dkontiscom/cinetracker/hardware/carrier/fab/carrier-v0.61-1to1-fit-check.pdf

## CineTracker carrier v0.61 - 1:1 fit check (print at 100 %, no scaling)

Board outline, silkscreen, fab and courtyard layers. The 50 mm bar must measure 50.0 mm on paper.
Place the physical M8 sockets, BNC, Teensy 4.1 (USB to the left) and the 1x4 header on the outlines. Connector courtyards = body outlines from the vendor drawings.

50 mm

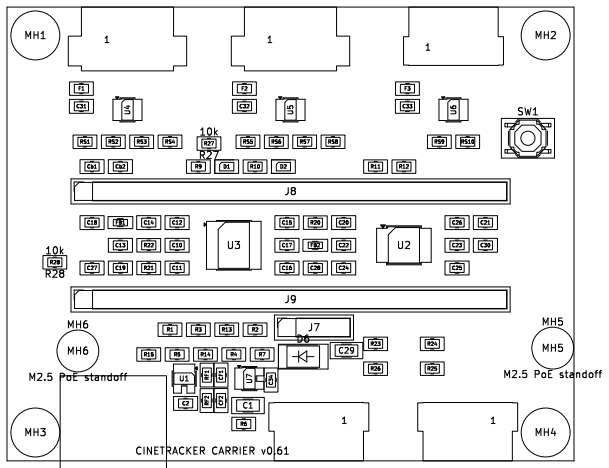
[picture p3: figure]
