dkontiscom/cinetracker/hardware/poe/fab/poe-v0.61-stack-1to1-fit-check.pdf

## CineTracker stack v0.61 / PoE v0.61 - 1:1 fit check (print at 100 %, no scaling)

Top view, carrier coordinates. Grey: carrier v0.61 (outline, silkscreen, courtyards). Red: PoE board v0.61 (outline, copper, silkscreen, courtyards). Panel edge at y = 64 for both boards. Connectors are drawn by their on-board courtyards. The 50 mm bar must measure 50.0 mm on paper.

50 mm

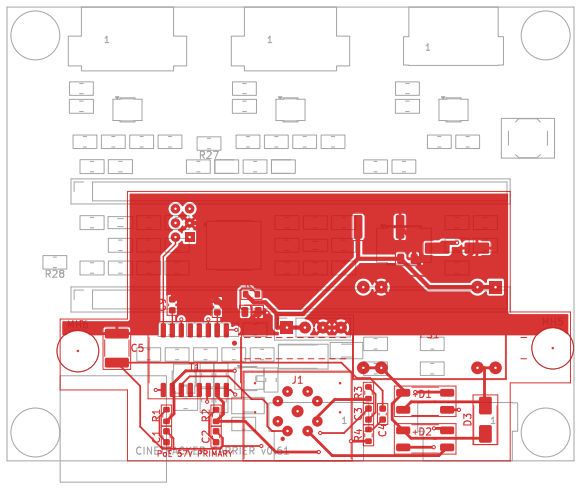
[picture p4: figure]
