dkontiscom/cinetracker/hardware/poe/documentation/poe-v0.61-bottom.png

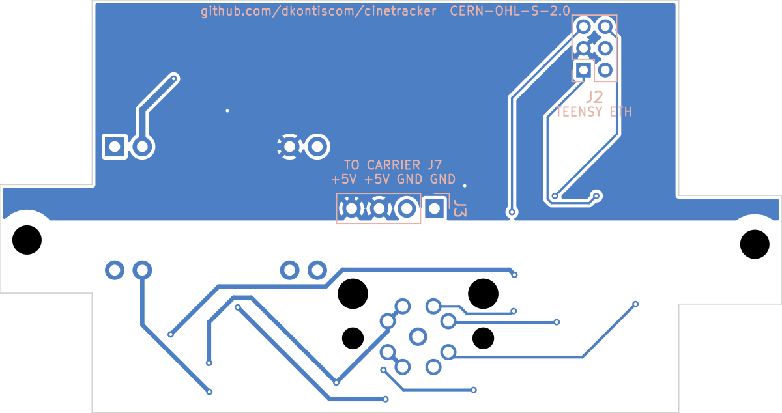
hardware/poe/documentation/poe-v0.61-bottom.png
