dkontiscom/cinetracker/hardware/poe/documentation/poe-v0.61-top.png

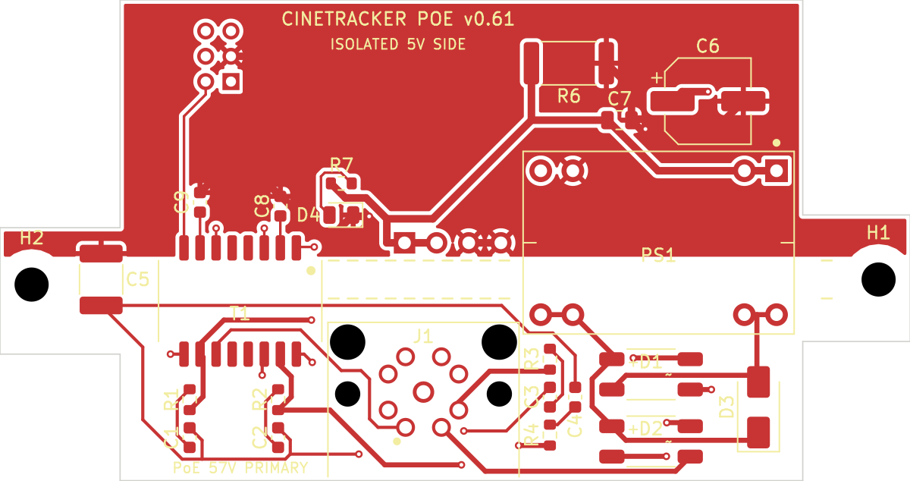
hardware/poe/documentation/poe-v0.61-top.png
