dkontiscom/cinetracker/hardware/carrier/fab/carrier-v0.61-BOM-full.csv

Qty/board | Designator | Description | Manufacturer | MPN | LCSC | JLC library | Process | JLC stock (2026-10-11) | Bought for 5 boards (incl. attrition) | Unit USD | Line USD
2 | C1,C29 | 47uF 10V X5R 1206 | Samsung | CL31A476MPHNNNE | C96123 | Basic | SMT | 390122 | 14 | 0.2593 | 3.63
12 | C2,C12,C14,C15,C17,C20,C22,C24,C31,C32,C33,C34 | 100nF 50V X7R 0805 | YAGEO | CC0805KRX7R9BB104 | C49678 | Basic | SMT | 19827943 | 70 | 0.0189 | 1.32
2 | C10,C11 | 2.2uF 25V X7R 0805 | Samsung | CL21B225KAFNNNE | C19110 | Extended | SMT | 94974 | 20 | 0.0328 | 0.66
9 | C13,C16,C21,C23,C25,C27,C28,Cb1,Cb2 | 10uF 25V X5R 0805 | Samsung | CL21A106KAYNNNE | C15850 | Basic | SMT | 4331515 | 55 | 0.0688 | 3.78
2 | C18,C19 | 2.2nF 50V C0G 0805 | Samsung | CL21C222JBFNNNE | C28260 | Basic | SMT | 98301 | 14 | 0.0202 | 0.28
2 | C26,C30 | 1uF 50V X7R 0805 | Samsung | CL21B105KBFNNNE | C28323 | Basic | SMT | 1825289 | 20 | 0.04 | 0.8
2 | CF1,CF2 | 68pF 50V NP0/C0G ±1% 0805 | YAGEO | CC0805FRNPO9BN680 | C541517 | Extended | SMT | 6909 | 18 | 0.0334 | 0.6
1 | D1 | LED yellow-green 0805 | Hubei KENTO | KT-0805YG | C2292 | Extended | SMT | 13261 | 15 | 0.0161 | 0.24
1 | D2 | LED yellow 0805 | Hubei KENTO | KT-0805Y | C2296 | Basic | SMT | 322508 | 15 | 0.0153 | 0.23
3 | D3,D4,D5 | bidir ESD +/-9V X1SON-2 (DPY) | Texas Instruments | TPD1E10B09DPYR | C88031 | Extended | SMT | 120763 | 19 | 0.0891 | 1.69
1 | D6 | TVS 5V uni 400W SMA | Littelfuse | SMAJ5.0A | C83329 | Extended | SMT | 29987 | 7 | 0.1237 | 0.87
3 | F1,F2,F3 | PTC 0.1A hold 0.3A trip 0805 | Bourns | MF-PSMF010X-2 | C116171 | Extended | SMT | 52217 | 23 | 0.0514 | 1.18
2 | FB1,FB2 | 600R@100MHz 500mA 0805 | Sunlord | GZ2012D601TF | C1017 | Basic | SMT | 311642 | 20 | 0.0201 | 0.4
1 | J1 | BNC 75ohm RA bulkhead THT | Kinghelm | KH-BNC75-3511 | C2837588 | Extended | THT | 734 | 5 | 0.9496 | 4.75
1 | J2 | M8 4P A female RA THT | CAZN | M8-S4A-GPL M10-JD | C19108970 | Extended | THT | 264 | 5 | 5.0197 | 25.1
2 | J3,J4 | M8 6P A female RA THT | dosinconn | DS869FPR0470-6P | C42395389 | Extended | THT | 53 | 10 | 3.8584 | 38.58
2 | J5,J6 | M8 3P female RA THT | CAZN | M8-S3A-GPLM10 | C42931206 | Extended | THT | 265 | 10 | 4.1157 | 41.16
1 | J7 | 1x4 female 2.54mm 8.5mm THT (5V in) | XKB Connection | X6511FV-04-C85D32 | C718241 | Extended | THT | 5001 | 6 | 0.2053 | 1.23
2 | J8,J9 | 1x24 female 2.54mm 8.5mm THT | XKB Connection | X6511FV-24-C85D32 | C2883741 | Extended | THT | 978 | 10 | 0.645 | 6.45
3 | R1,R2,R4 | 2k 0.1% 50ppm thin film 0805 | YAGEO | RT0805BRE072KL | C706274 | Extended | SMT | 116950 | 19 | 0.0546 | 1.04
1 | R3 | 1k 0.1% 25ppm thin film 0805 | YAGEO | RT0805BRD071KL | C110774 | Extended | SMT | 295592 | 13 | 0.0429 | 0.56
1 | R5 | 5.1k 0.1% 25ppm thin film 0805 | YAGEO | RT0805BRD075K1L | C122968 | Extended | SMT | 95105 | 9 | 0.059 | 0.53
1 | R6 | 75R 1% 0805 | YAGEO | RC0805FR-0775RL | C141697 | Extended | SMT | 145170 | 15 | 0.0076 | 0.11
5 | R7,R20,R25,R27,R28 | 10k 1% 0805 | UNI-ROYAL | 0805W8F1002T5E | C17414 | Basic | SMT | 58488066 | 35 | 0.0033 | 0.12
4 | R9,R10,R21,R22 | 470R 1% 0805 | UNI-ROYAL | 0805W8F4700T5E | C17710 | Basic | SMT | 2704814 | 30 | 0.0048 | 0.14
2 | R11,R12 | 2k 1% 0805 | UNI-ROYAL | 0805W8F2001T5E | C17604 | Basic | SMT | 5272441 | 20 | 0.0039 | 0.08
1 | R13 | 11R 1% 0805 | UNI-ROYAL | 0805W8F110JT5E | C17430 | Extended | SMT | 19227 | 15 | 0.0042 | 0.06
1 | R14 | 22R 1% 0805 | UNI-ROYAL | 0805W8F220JT5E | C17561 | Basic | SMT | 1632160 | 15 | 0.0045 | 0.07
1 | R15 | 5.6k 0.1% 25ppm thin film 0805 | PANASONIC | ERA6AEB562V | C445654 | Extended | SMT | 8029 | 9 | 0.0896 | 0.81
1 | R23 | 4.7k 1% 0805 | UNI-ROYAL | 0805W8F4701T5E | C17673 | Basic | SMT | 4702678 | 11 | 0.005 | 0.06
1 | R24 | 20k 1% 0805 | UNI-ROYAL | 0805W8F2002T5E | C4328 | Basic | SMT | 2350704 | 15 | 0.0042 | 0.06
1 | R26 | 1k 1% 0805 | UNI-ROYAL | 0805W8F1001T5E | C17513 | Basic | SMT | 45444566 | 15 | 0.0035 | 0.05
2 | RF1,RF2 | 150R 1% 0805 | UNI-ROYAL | 0805W8F1500T5E | C17471 | Basic | SMT | 439192 | 20 | 0.0056 | 0.11
10 | RS1,RS2,RS3,RS4,RS5,RS6,RS7,RS8,RS9,RS10 | 33R 1% 0805 | UNI-ROYAL | 0805W8F330JT5E | C17634 | Basic | SMT | 1515902 | 60 | 0.0047 | 0.28
1 | SW1 | Tact switch 5.1x5.1 SMD | XKB Connection | TS-1187A-B-A-B | C318884 | Basic | SMT | 382383 | 10 | 0.0206 | 0.21
2 | U1,U7 | 200MHz 360V/us op-amp SOT-23-5 | Texas Instruments | OPA356AIDBVR | C183100 | Extended | SMT | 947 | 10 | 1.0294 | 10.29
1 | U2 | Audio ADC 24-bit I2S TSSOP-14 | Texas Instruments | PCM1808PWR | C55513 | Extended | SMT | 15552 | 5 | 0.702 | 3.51
1 | U3 | Audio DAC 32-bit I2S TSSOP-20 | Texas Instruments | PCM5102APWR | C107671 | Extended | SMT | 7737 | 5 | 1.4463 | 7.23
3 | U4,U5,U6 | 4-ch ESD 5.5V SOT-23-6 | Texas Instruments | TPD4E1U06DBVR | C124691 | Extended | SMT | 23206 | 15 | 0.3649 | 5.47
