dkontiscom/cinetracker/hardware/poe/fab/poe-v0.61-BOM-full.csv

Qty/board | Designator | Description | Manufacturer | MPN | LCSC | JLC library | Process | JLC stock (2026-10-11) | Bought for 5 boards (incl. attrition) | Unit USD | Line USD
4 | C1,C2,C3,C4 | 10 nF 100 V X7R 0603 | YAGEO | CC0603KRX7R0BB103 | C107059 | Extended | SMT | 1242847 | 32 | 0.0089 | 0.28
1 | C5 | 1 nF 2 kV X7R 1812 | YAGEO | CC1812KKX7RDBB102 | C118019 | Extended | SMT | 12367 | 5 | 0.3953 | 1.98
1 | C6 | 100 uF 25 V aluminium electrolytic, 6.3 x 5.4 | KNSCHA | RST100UF25V004 | C4747964 | Extended | SMT | 263590 | 6 | 0.0413 | 0.25
1 | C7 | 10 uF 25 V X5R 0805 | Samsung | CL21A106KAYNNNE | C15850 | Basic | SMT | 4331725 | 15 | 0.0688 | 1.03
2 | C8,C9 | 100 nF 50 V X7R 0603 | YAGEO | CC0603KRX7R9BB104 | C14663 | Basic | SMT | 56599620 | 20 | 0.014 | 0.28
2 | D1,D2 | Bridge rectifier 600 V 1 A, MBS | MDD | MB6S | C2487 | Extended | SMT | 237940 | 15 | 0.0276 | 0.41
1 | D3 | TVS 58 V unidirectional, SMA | GOODWORK | SMAJ58A | C2980408 | Extended | SMT | 40883 | 13 | 0.0326 | 0.42
1 | D4 | LED green 0805 | Hubei KENTO | KT-0805G | C2297 | Basic | SMT | 2908107 | 15 | 0.0163 | 0.24
1 | J1 | M12 X-coded 8-pin female, right angle, PCB, 60 V, IEC 61076-2-109 | CAZN | M12-S8X-GPLM12-BJD | C7423431 | Extended | THT | 48 | 5 | 10.0653 | 50.33
1 | PS1 | 802.3af PD module, isolated 5 V 1.4 A (7 W at 70 C) | SDAPO | DP9900LP-5V | C5380108 | Extended | THT | 468 | 5 | 6.2624 | 31.31
4 | R1,R2,R3,R4 | 75 ohm 1% 0603 | UNI-ROYAL | 0603WAF750JT5E | C4275 | Basic | SMT | 1634250 | 30 | 0.0033 | 0.1
1 | R7 | 2.2 kohm 1% 0603 | UNI-ROYAL | 0603WAF2201T5E | C4190 | Basic | SMT | 7231901 | 15 | 0.0018 | 0.03
1 | T1 | 10/100 PoE+ LAN transformer with CMC, 720 mA, 1500 Vrms | CND-tek | B1608S | C507596 | Extended | SMT | 13658 | 5 | 0.302 | 1.51
1 | R6 | DNP |  |  |  |  | DNP (bleeder option)
1 | J3 | 5V to carrier J7 |  |  |  |  | long-pin header, fitted by hand (see design notes)
1 | J2 | 2x3 female header 2.0 mm, 4.3 mm, through hole (hand-solder, bottom side) | HanElectricity | 2005FV-2x3P | C18723065 |  | hand-soldered on the bottom side
