dkontiscom/cinetracker/hardware/carrier/documentation/cinetracker-carrier-v0.61-schematic.pdf

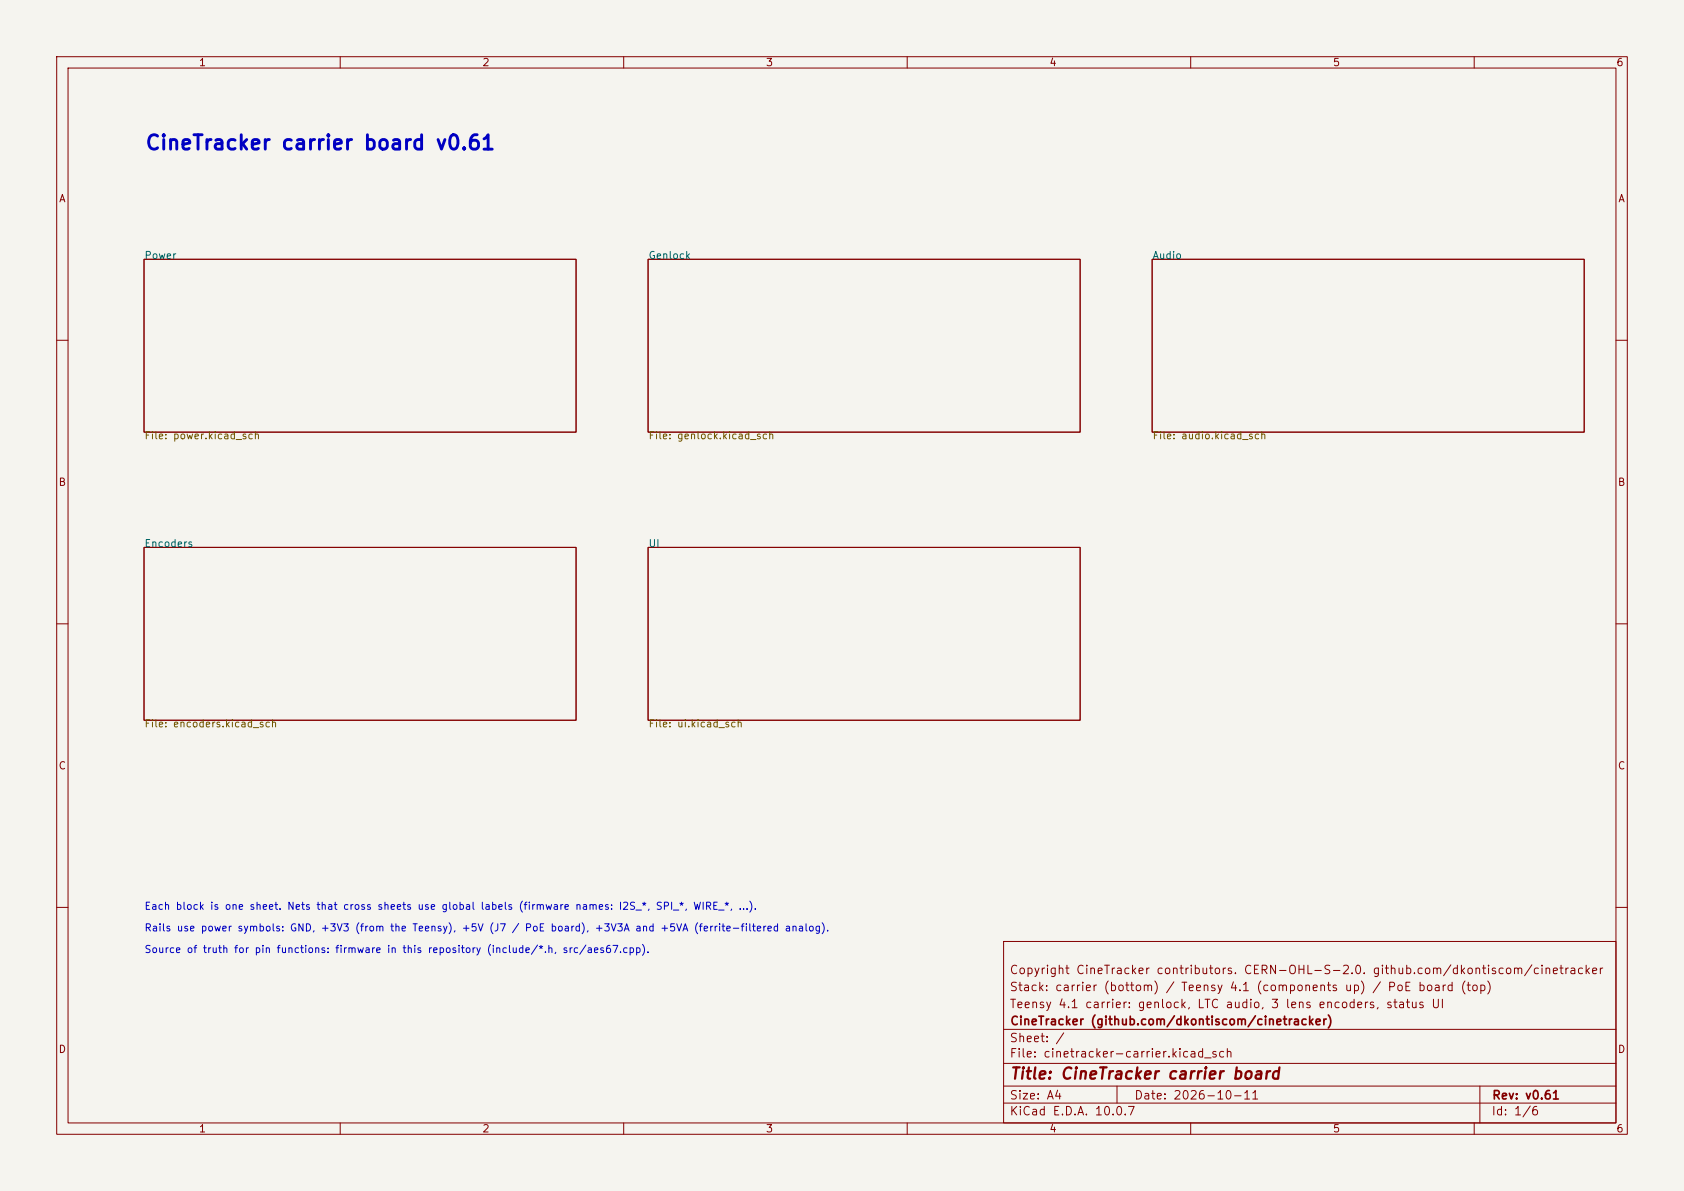
[picture p7: page 1]

Copyright CineTracker contributors. CERN-OHL-S-2.0. github.com/dkontiscom/cinetracker Encoders File: encoders.kicad_sch Power File: power.kicad_sch

File: audio.kicad_sch Genlock File: genlock.kicad_sch UI File: ui.kicad_sch

Each block is one sheet. Nets that cross sheets use global labels (firmware names: I2S_*, SPI_*, WIRE_*, ...). Rails use power symbols: GND, +3V3 (from the Teensy), +5V (J7 / PoE board), +3V3A and +5VA (ferrite-filtered analog). Source of truth for pin functions: firmware in this repository (include/*.h, src/aes67.cpp).

Stack: carrier (bottom) / Teensy 4.1 (components up) / PoE board (top)
Teensy 4.1 carrier: genlock, LTC audio, 3 lens encoders, status UI
CineTracker (github.com/dkontiscom/cinetracker)
Sheet: /
File: cinetracker-carrier.kicad_sch
Title: CineTracker carrier board

Size: A4 | Rev: v0.61
KiCad E.D.A. 10.0.7 | Id: 1/6

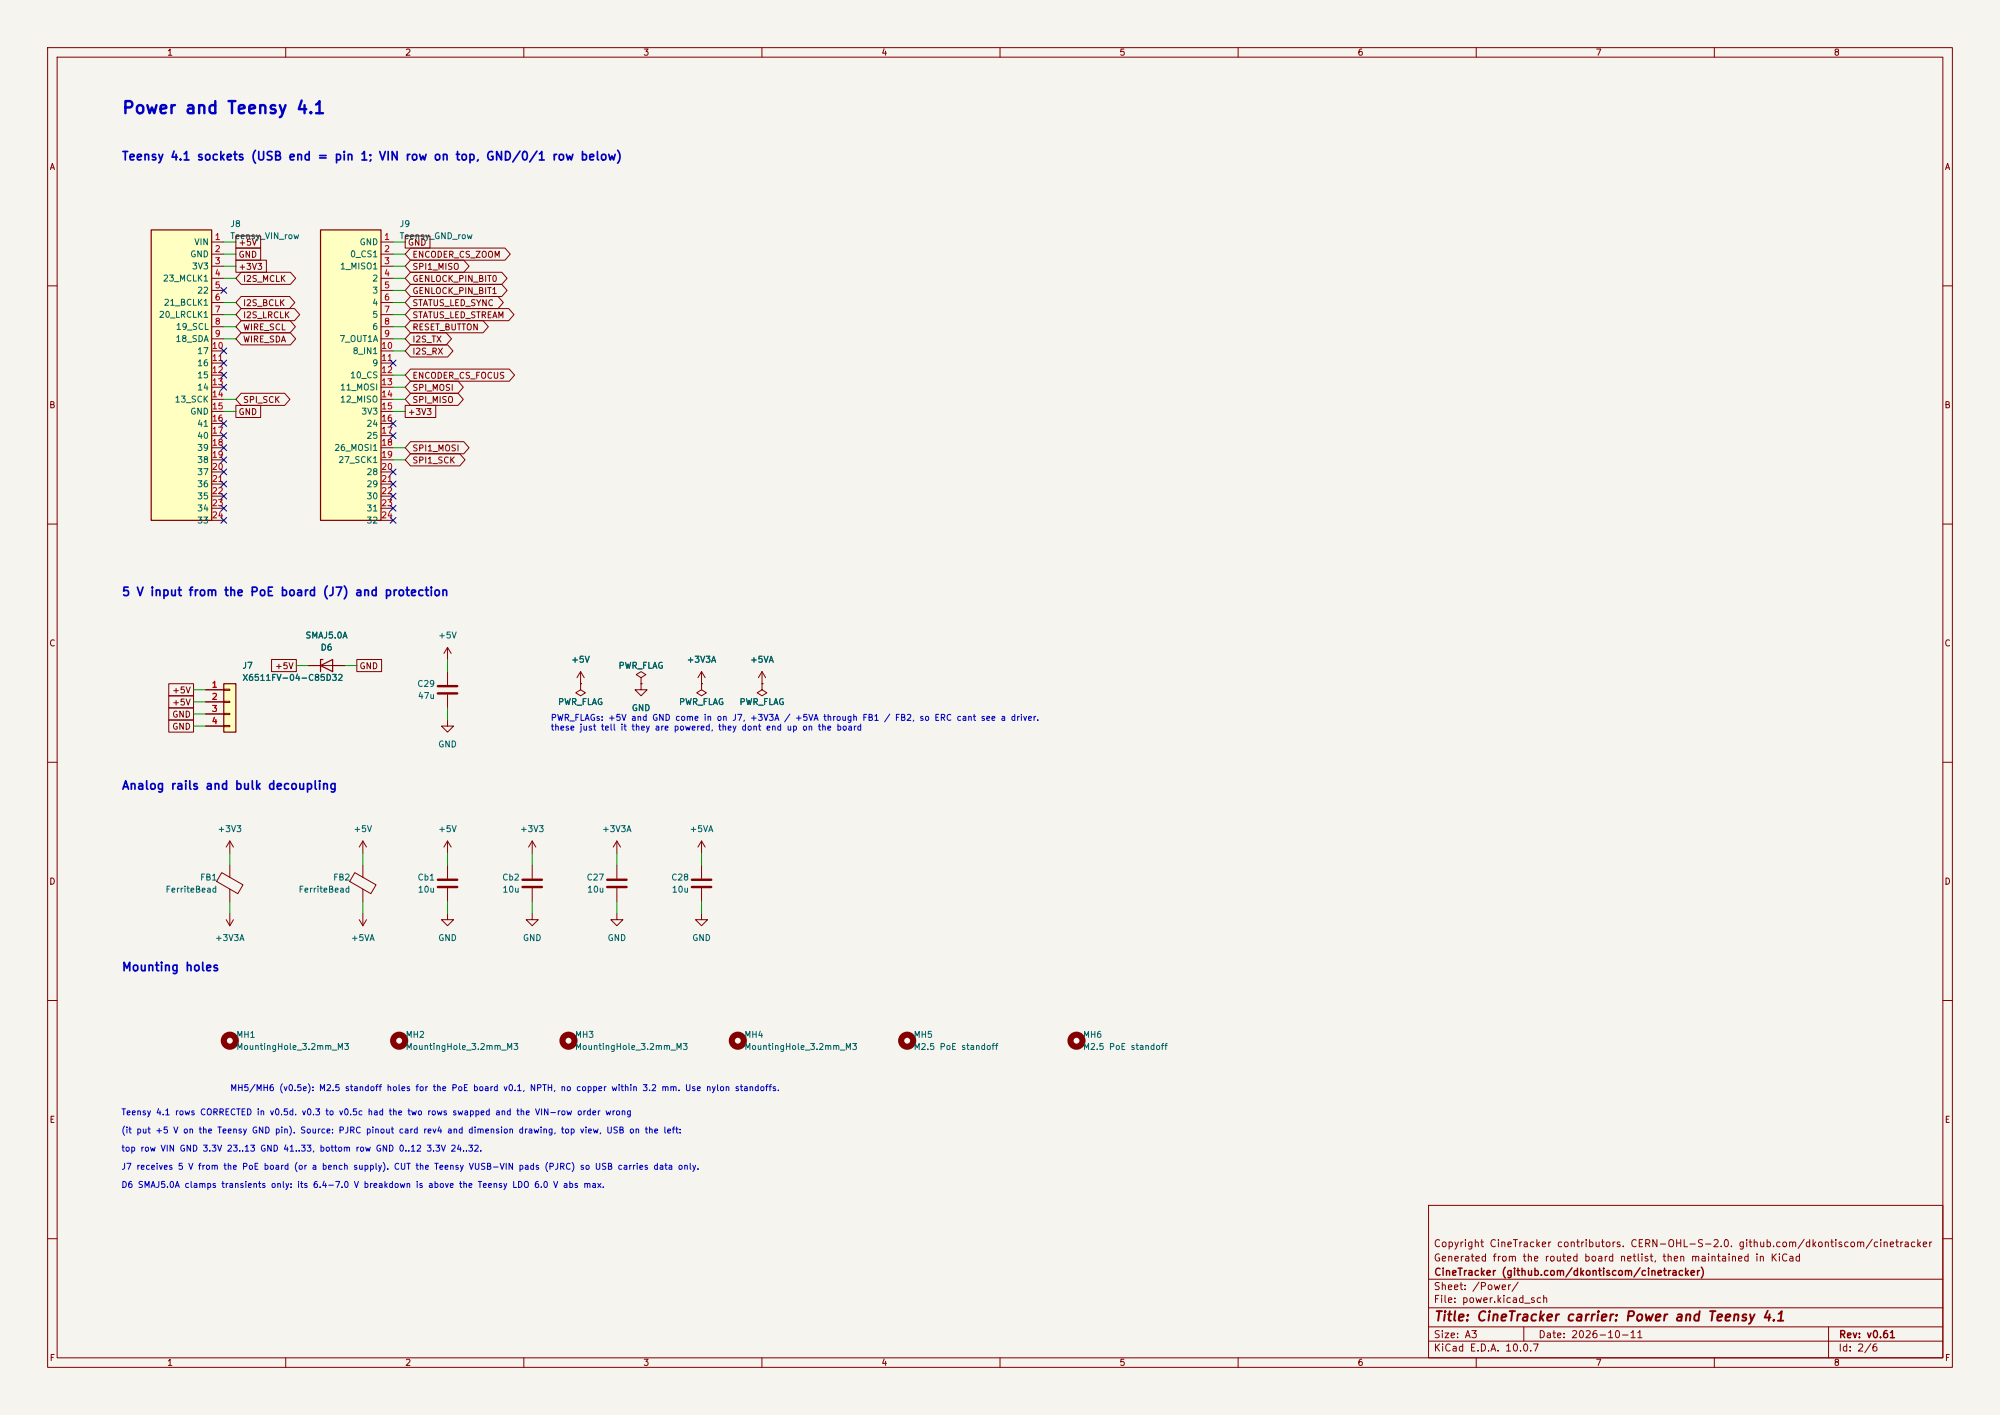
[picture p8: page 2]

SPI_MOSI Teensy 4.1 sockets (USB end = pin 1; VIN row on top, GND/0/1 row below)

5 V input from the PoE board (J7) and protection

PWR_FLAGs: +5V and GND come in on J7, +3V3A / +5VA through FB1 / FB2, so ERC cant see a driver. these just tell it they are powered, they dont end up on the board Analog rails and bulk decoupling

MH5/MH6 (v0.5e): M2.5 standoff holes for the PoE board v0.1, NPTH, no copper within 3.2 mm. Use nylon standoffs. Teensy 4.1 rows CORRECTED in v0.5d. v0.3 to v0.5c had the two rows swapped and the VIN-row order wrong

(it put +5 V on the Teensy GND pin). Source: PJRC pinout card rev4 and dimension drawing, top view, USB on the left: J7 receives 5 V from the PoE board (or a bench supply). CUT the Teensy VUSB-VIN pads (PJRC) so USB carries data only.

top row VIN GND 3.3V 23..13 GND 41..33, bottom row GND 0..12 3.3V 24..32. D6 SMAJ5.0A clamps transients only: its 6.4-7.0 V breakdown is above the Teensy LDO 6.0 V abs max.

Copyright CineTracker contributors. CERN-OHL-S-2.0. github.com/dkontiscom/cinetracker
Generated from the routed board netlist, then maintained in KiCad
CineTracker (github.com/dkontiscom/cinetracker)
Sheet: /Power/
File: power.kicad_sch
Title: CineTracker carrier: Power and Teensy 4.1

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
# Title: CineTracker carrier: Genlock: tri-level sync output

### File: genlock.kicad_sch

### Sheet: /Genlock/

## CineTracker (github.com/dkontiscom/cinetracker)

### Generated from the routed board netlist, then maintained in KiCad

### Copyright CineTracker contributors. CERN-OHL-S-2.0. github.com/dkontiscom/cinetracker

+3V3A GND

R6
75R

GND

R3
1k 0.1%

R1
2k 0.1%

R13
11R

R2
2k 0.1%

RF2
150R

GND

C1

47u | R7
10k | GND

R15
5k6 0.1% V-

2 V+

5
1 +

3 -

4 | U7OPA356 +3V3A GND

D5

TPD1E10B09DPYR

GND

R5
5k1 0.1%

C34

100n GND +3V3A 1

2

# J1KH-BNC75-3511 R14

22R

CF1

68p | GND +3V3A | R4
2k 0.1% V-

2 V+

5
1 +

3 -

4 | U1OPA356 | GND

CF2

68p RF1
150R

C2

100n +3V3A GENLOCK_PIN_BIT1 | GENLOCK_PIN_BIT0 | GND GENLOCK_DCBLK

GENLOCK_R4M

GENLOCK_R4M

GENLOCK_NODE_B

GENLOCK_BNC_SIG

GENLOCK_NODE_S | GENLOCK_BUF_OUT GENLOCK_BNC_SIG

GENLOCK_BNC_SIG

GENLOCK_SKP | GENLOCK_BUF_OUT GENLOCK_SKM

GENLOCK_DCBLK

GENLOCK_SKM

GENLOCK_SKM

# GENLOCK_BUF1 GENLOCK_BUF_OUT GENLOCK_DCBLK

GENLOCK_SKP

GENLOCK_NODE_B | GENLOCK_NODE_B
GENLOCK_BUF1 GENLOCK_BUF1 | GENLOCK_NODE_S GENLOCK_NODE_S | GENLOCK_NODE_S GENLOCK_NODE_S | GENLOCK_SKP

GENLOCK_BUF_OUT GENLOCK_R3M

GENLOCK_R3M

inside both ST 274 windows (24/25/30p 33.7-74.1 ns, 50/60p 16.8-37.0 ns). See documentation/genlock-simulation.md.

Sallen-Key RF 150 ohm / CF 68 pF 1% C0G, Q = 0.5: 10-90% rise 35.2 / 35.3 / 35.2 ns in SPICE (TI OPA356 model),

## DC block, 75 ohm source, ESD, BNC

Trailing edge needs BIT1-low and BIT0-high in one store: firmware writes them with one GPIO9 DR_TOGGLE store (commit ab11050). Firmware t41-tri-sync.h drives (BIT1,BIT0): 01 = blank 0 mV, 00 = -300 mV, 10 = +300 mV at the camera (75 ohm cable into 75 ohm). R15 5k6 to +3V3A || R5 5k1 to GND lifts the buffer levels to 0.43 / 1.03 / 1.63 V (inside OPA356 CM range, V+ - 1.5 V).

## Buffer, 2-pole Sallen-Key low-pass (Q = 0.5), line driver

# Genlock: tri-level sync output

## 2-bit R-2R ladder (BIT1 = MSB, pin 3; BIT0 = LSB, pin 2) with offset +3V3A U1OPA356 V-

2 V+

5
1 +

3 -

4 | U7OPA356 V-

2 V+

5
1 +

3 -

4+3V3A

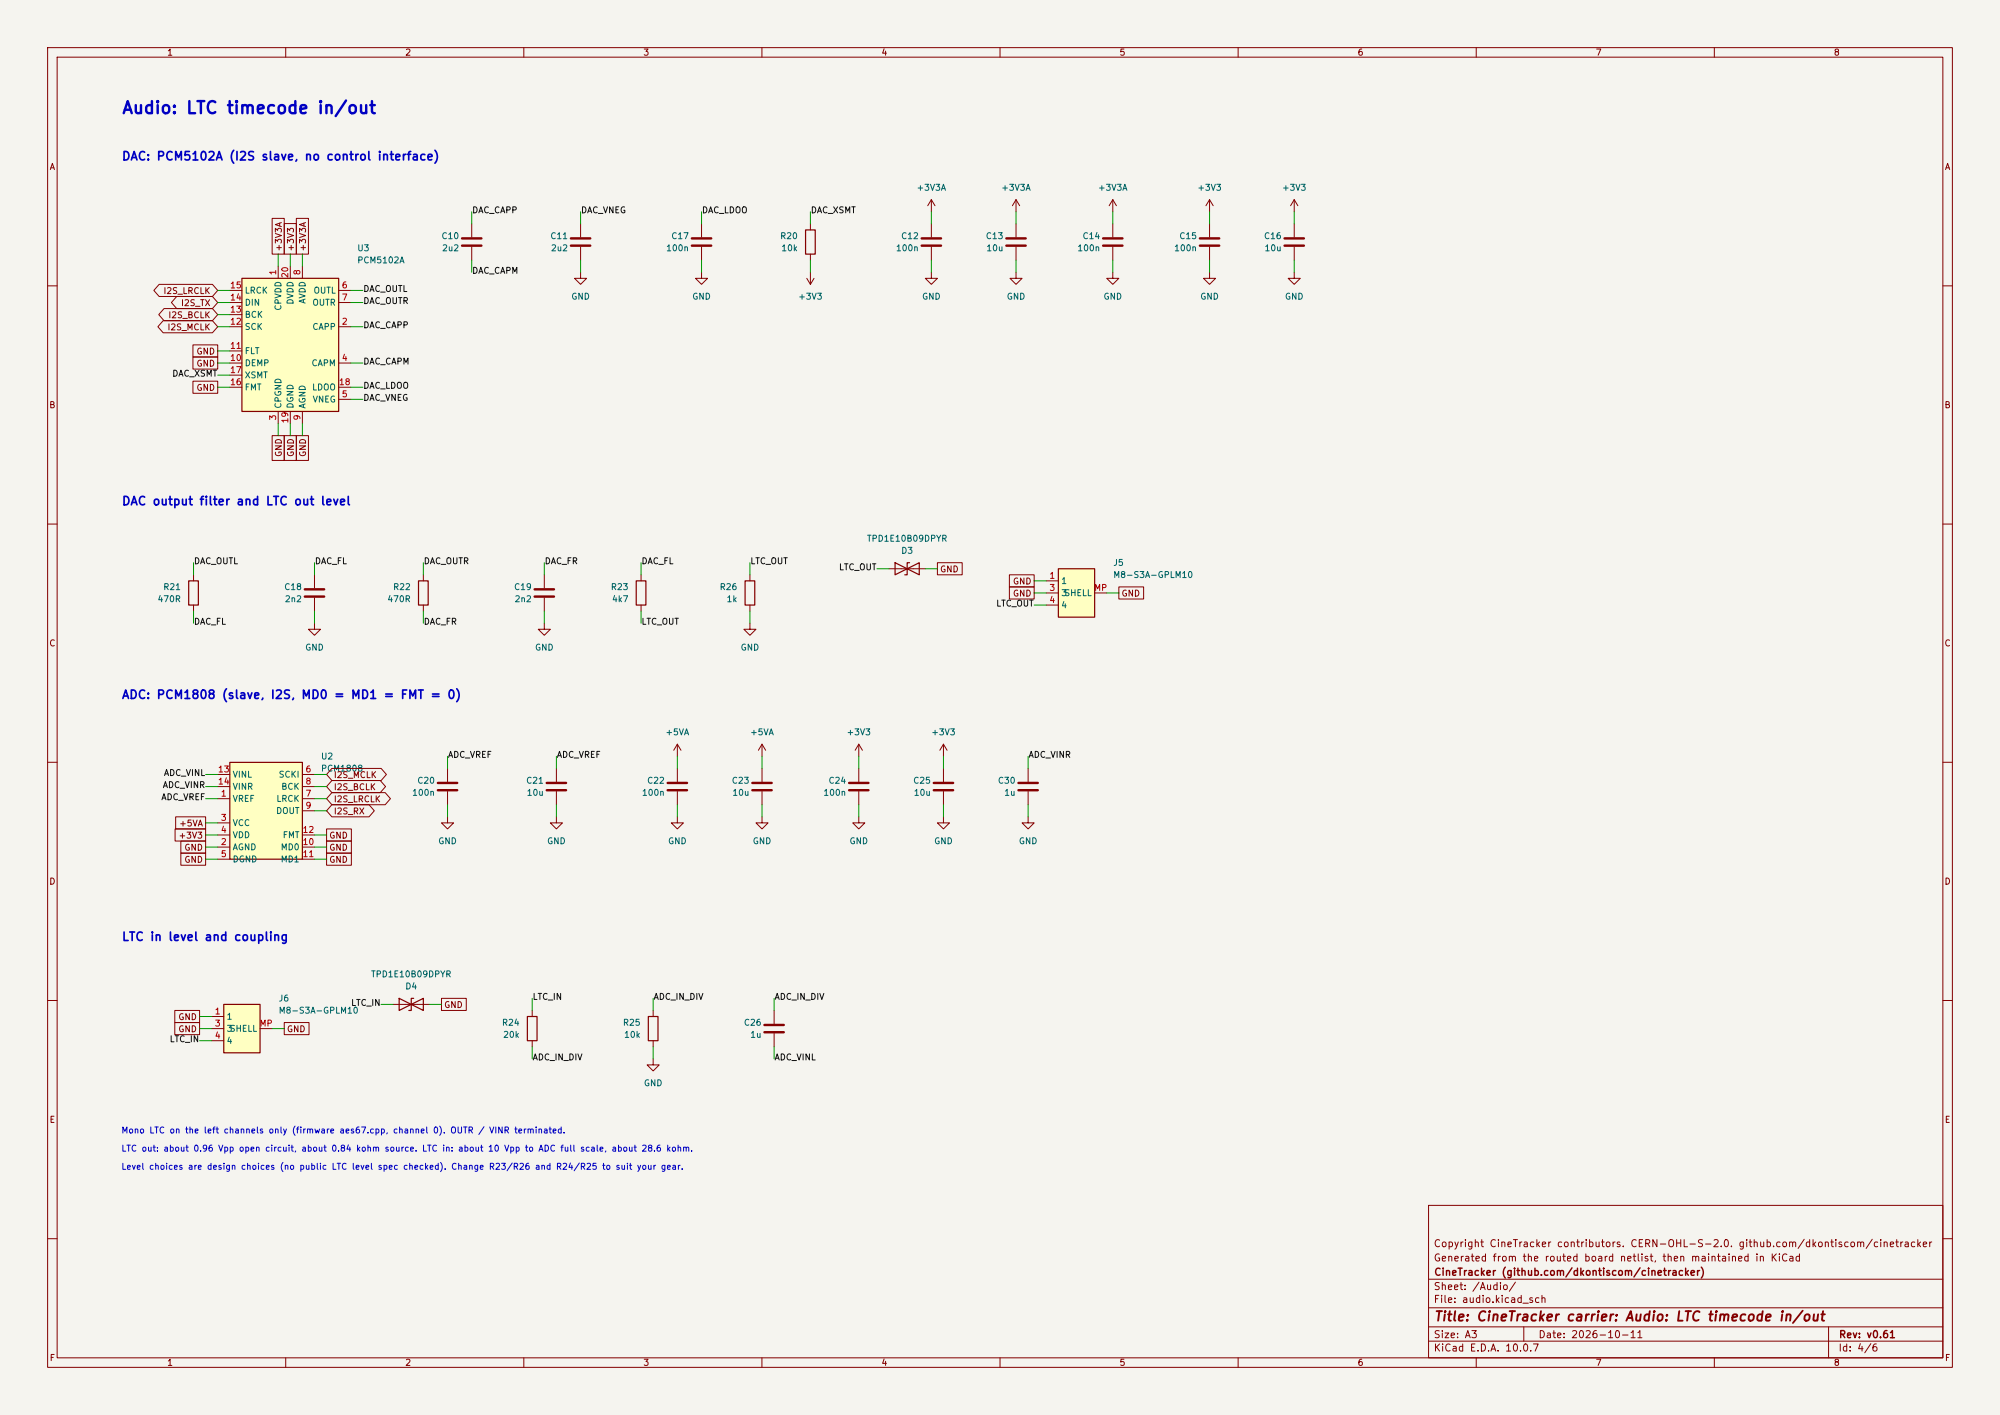
[picture p9: page 4]

Audio: LTC timecode in/out
470R CPVDD
DAC_OUTL DAC_LDOO

LTC_OUT DAC: PCM5102A (I2S slave, no control interface)

SCK 12 BCK 13 DIN 14 LRCK 15

DAC output filter and LTC out level

Level choices are design choices (no public LTC level spec checked). Change R23/R26 and R24/R25 to suit your gear. LTC in level and coupling

Mono LTC on the left channels only (firmware aes67.cpp, channel 0). OUTR / VINR terminated.

LTC out: about 0.96 Vpp open circuit, about 0.84 kohm source. LTC in: about 10 Vpp to ADC full scale, about 28.6 kohm.

Copyright CineTracker contributors. CERN-OHL-S-2.0. github.com/dkontiscom/cinetracker
Generated from the routed board netlist, then maintained in KiCad
CineTracker (github.com/dkontiscom/cinetracker)
Sheet: /Audio/
File: audio.kicad_sch
Title: CineTracker carrier: Audio: LTC timecode in/out

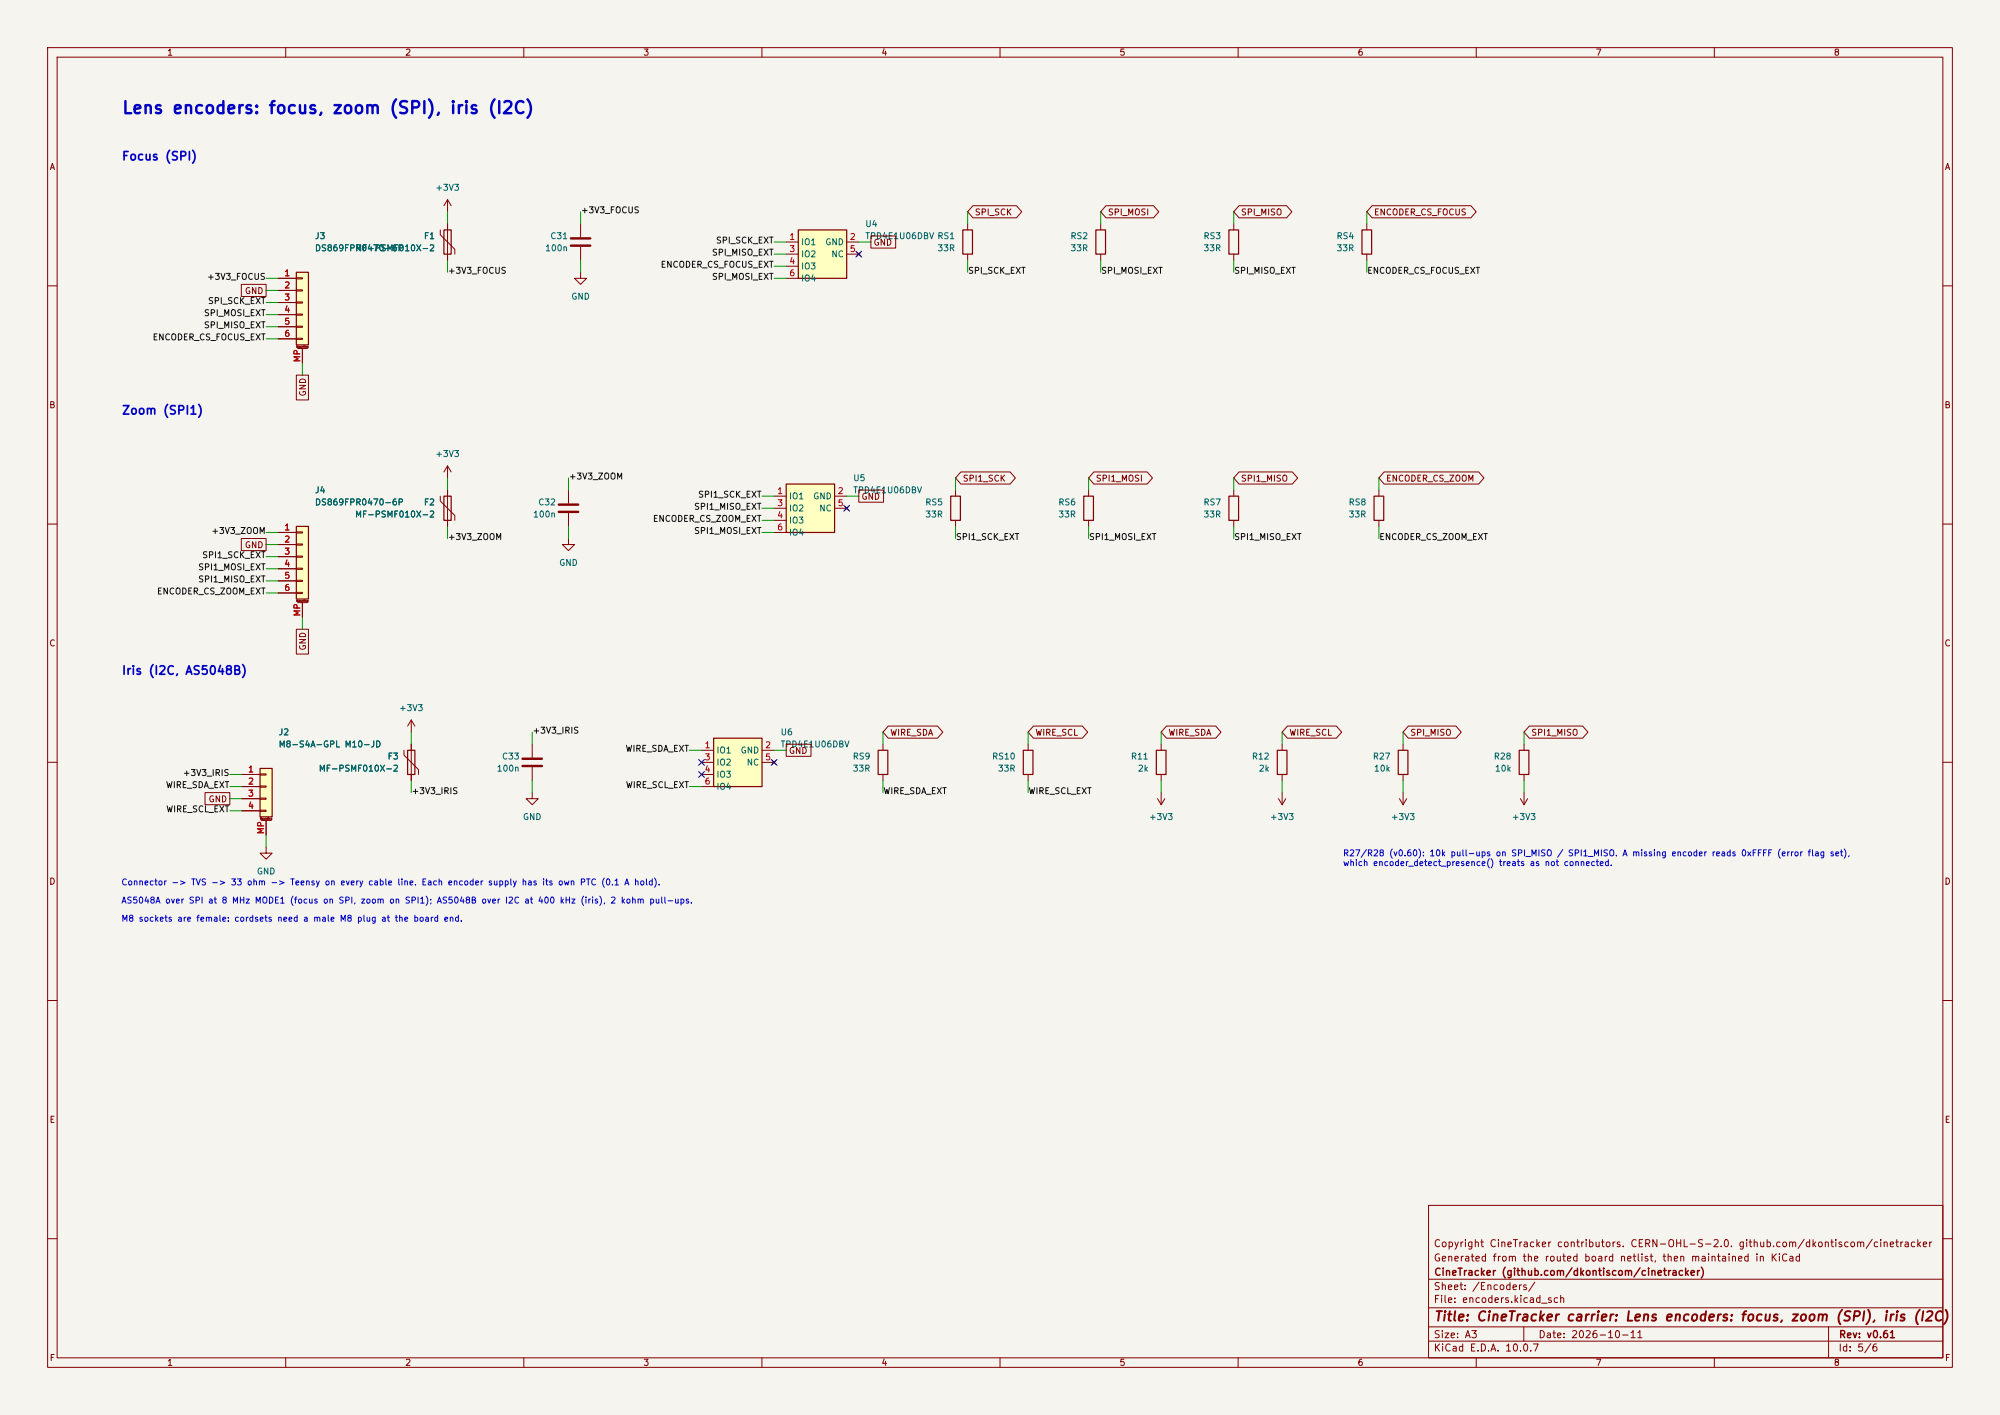
[picture p10: page 5]

Lens encoders: focus, zoom (SPI), iris (I2C)

Iris (I2C, AS5048B) Connector -> TVS -> 33 ohm -> Teensy on every cable line. Each encoder supply has its own PTC (0.1 A hold).

Copyright CineTracker contributors. CERN-OHL-S-2.0. github.com/dkontiscom/cinetracker +3V3

R27/R28 (v0.60): 10k pull-ups on SPI_MISO / SPI1_MISO. A missing encoder reads 0xFFFF (error flag set), which encoder_detect_presence() treats as not connected. AS5048A over SPI at 8 MHz MODE1 (focus on SPI, zoom on SPI1); AS5048B over I2C at 400 kHz (iris), 2 kohm pull-ups.

M8 sockets are female: cordsets need a male M8 plug at the board end.

Generated from the routed board netlist, then maintained in KiCad
CineTracker (github.com/dkontiscom/cinetracker)
Sheet: /Encoders/
File: encoders.kicad_sch
Title: CineTracker carrier: Lens encoders: focus, zoom (SPI), iris (I2C)

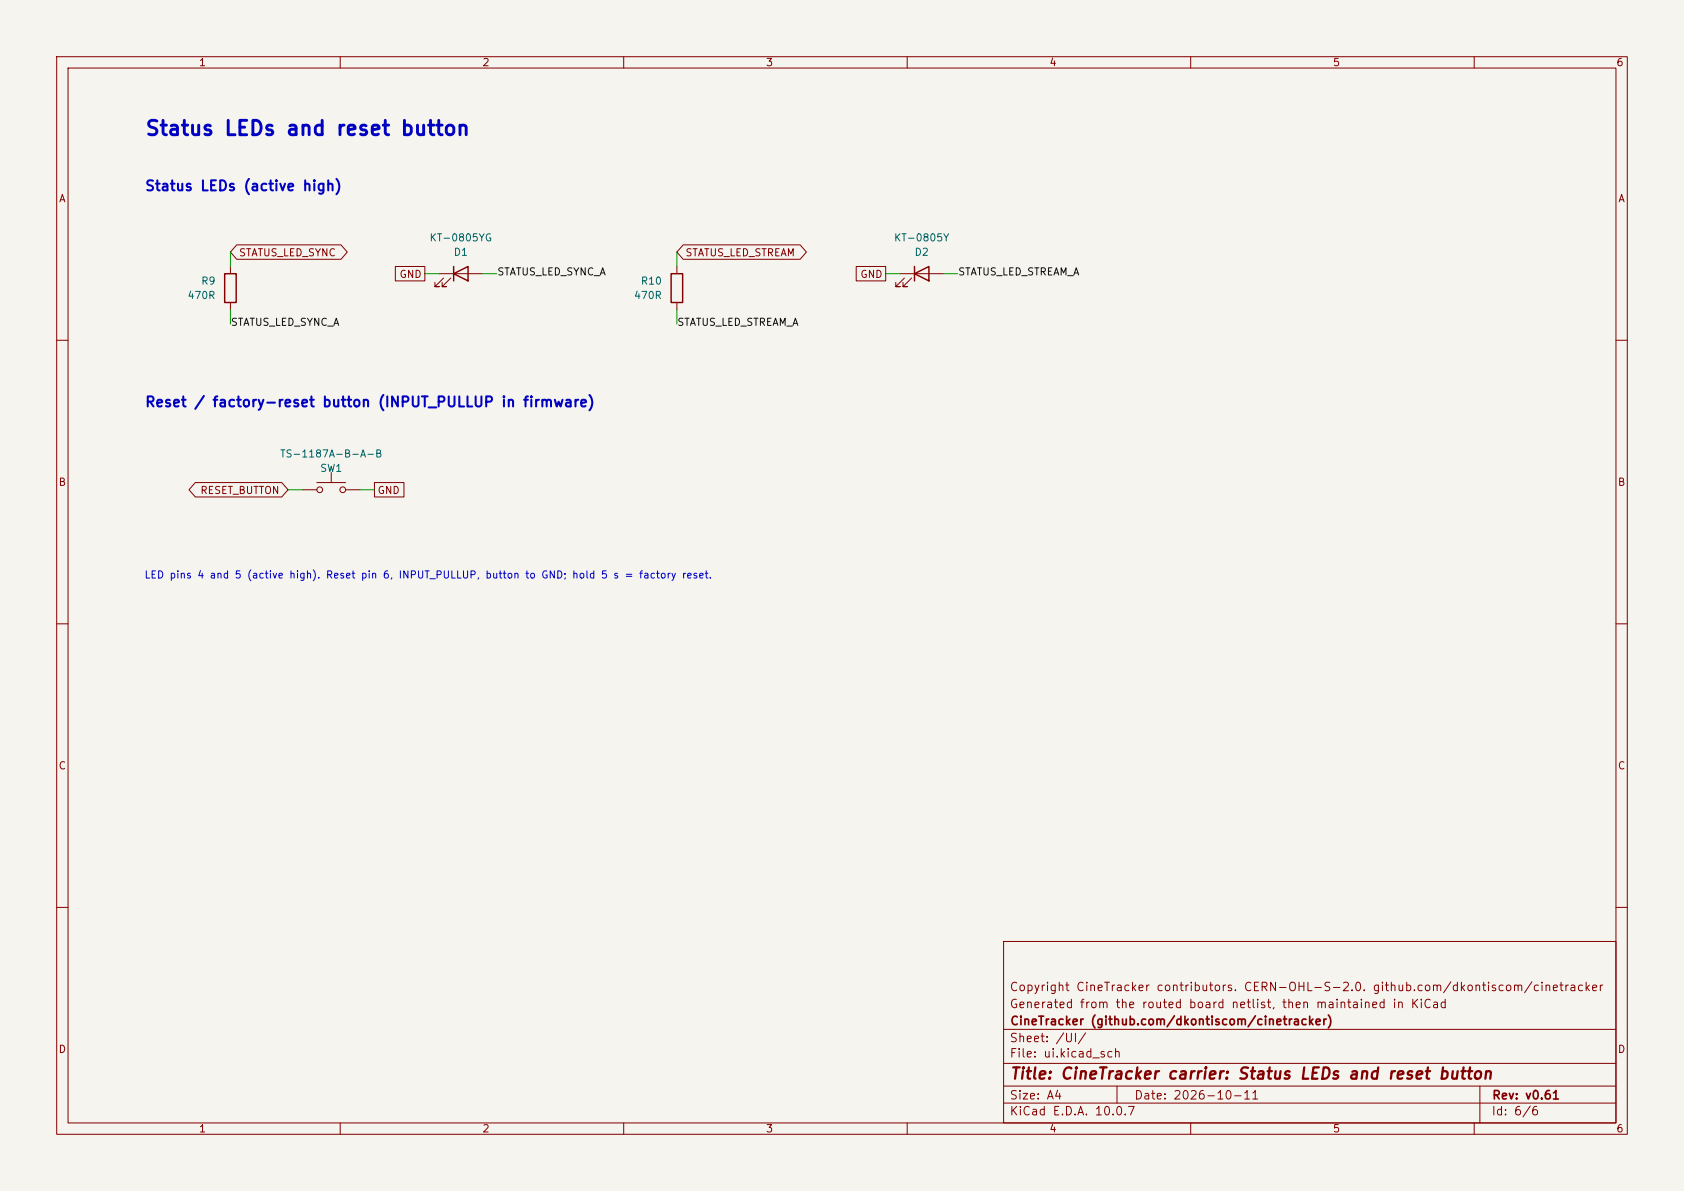
[picture p11: page 6]

LED pins 4 and 5 (active high). Reset pin 6, INPUT_PULLUP, button to GND; hold 5 s = factory reset. Status LEDs (active high)

Reset / factory-reset button (INPUT_PULLUP in firmware)

Copyright CineTracker contributors. CERN-OHL-S-2.0. github.com/dkontiscom/cinetracker
Generated from the routed board netlist, then maintained in KiCad
CineTracker (github.com/dkontiscom/cinetracker)
Sheet: /UI/
File: ui.kicad_sch
Title: CineTracker carrier: Status LEDs and reset button
