dkontiscom/cinetracker/hardware/poe/cinetracker-poe.kicad_pcb

## KiCad design hardware/poe/cinetracker-poe.kicad_pcb (2026-10-11)

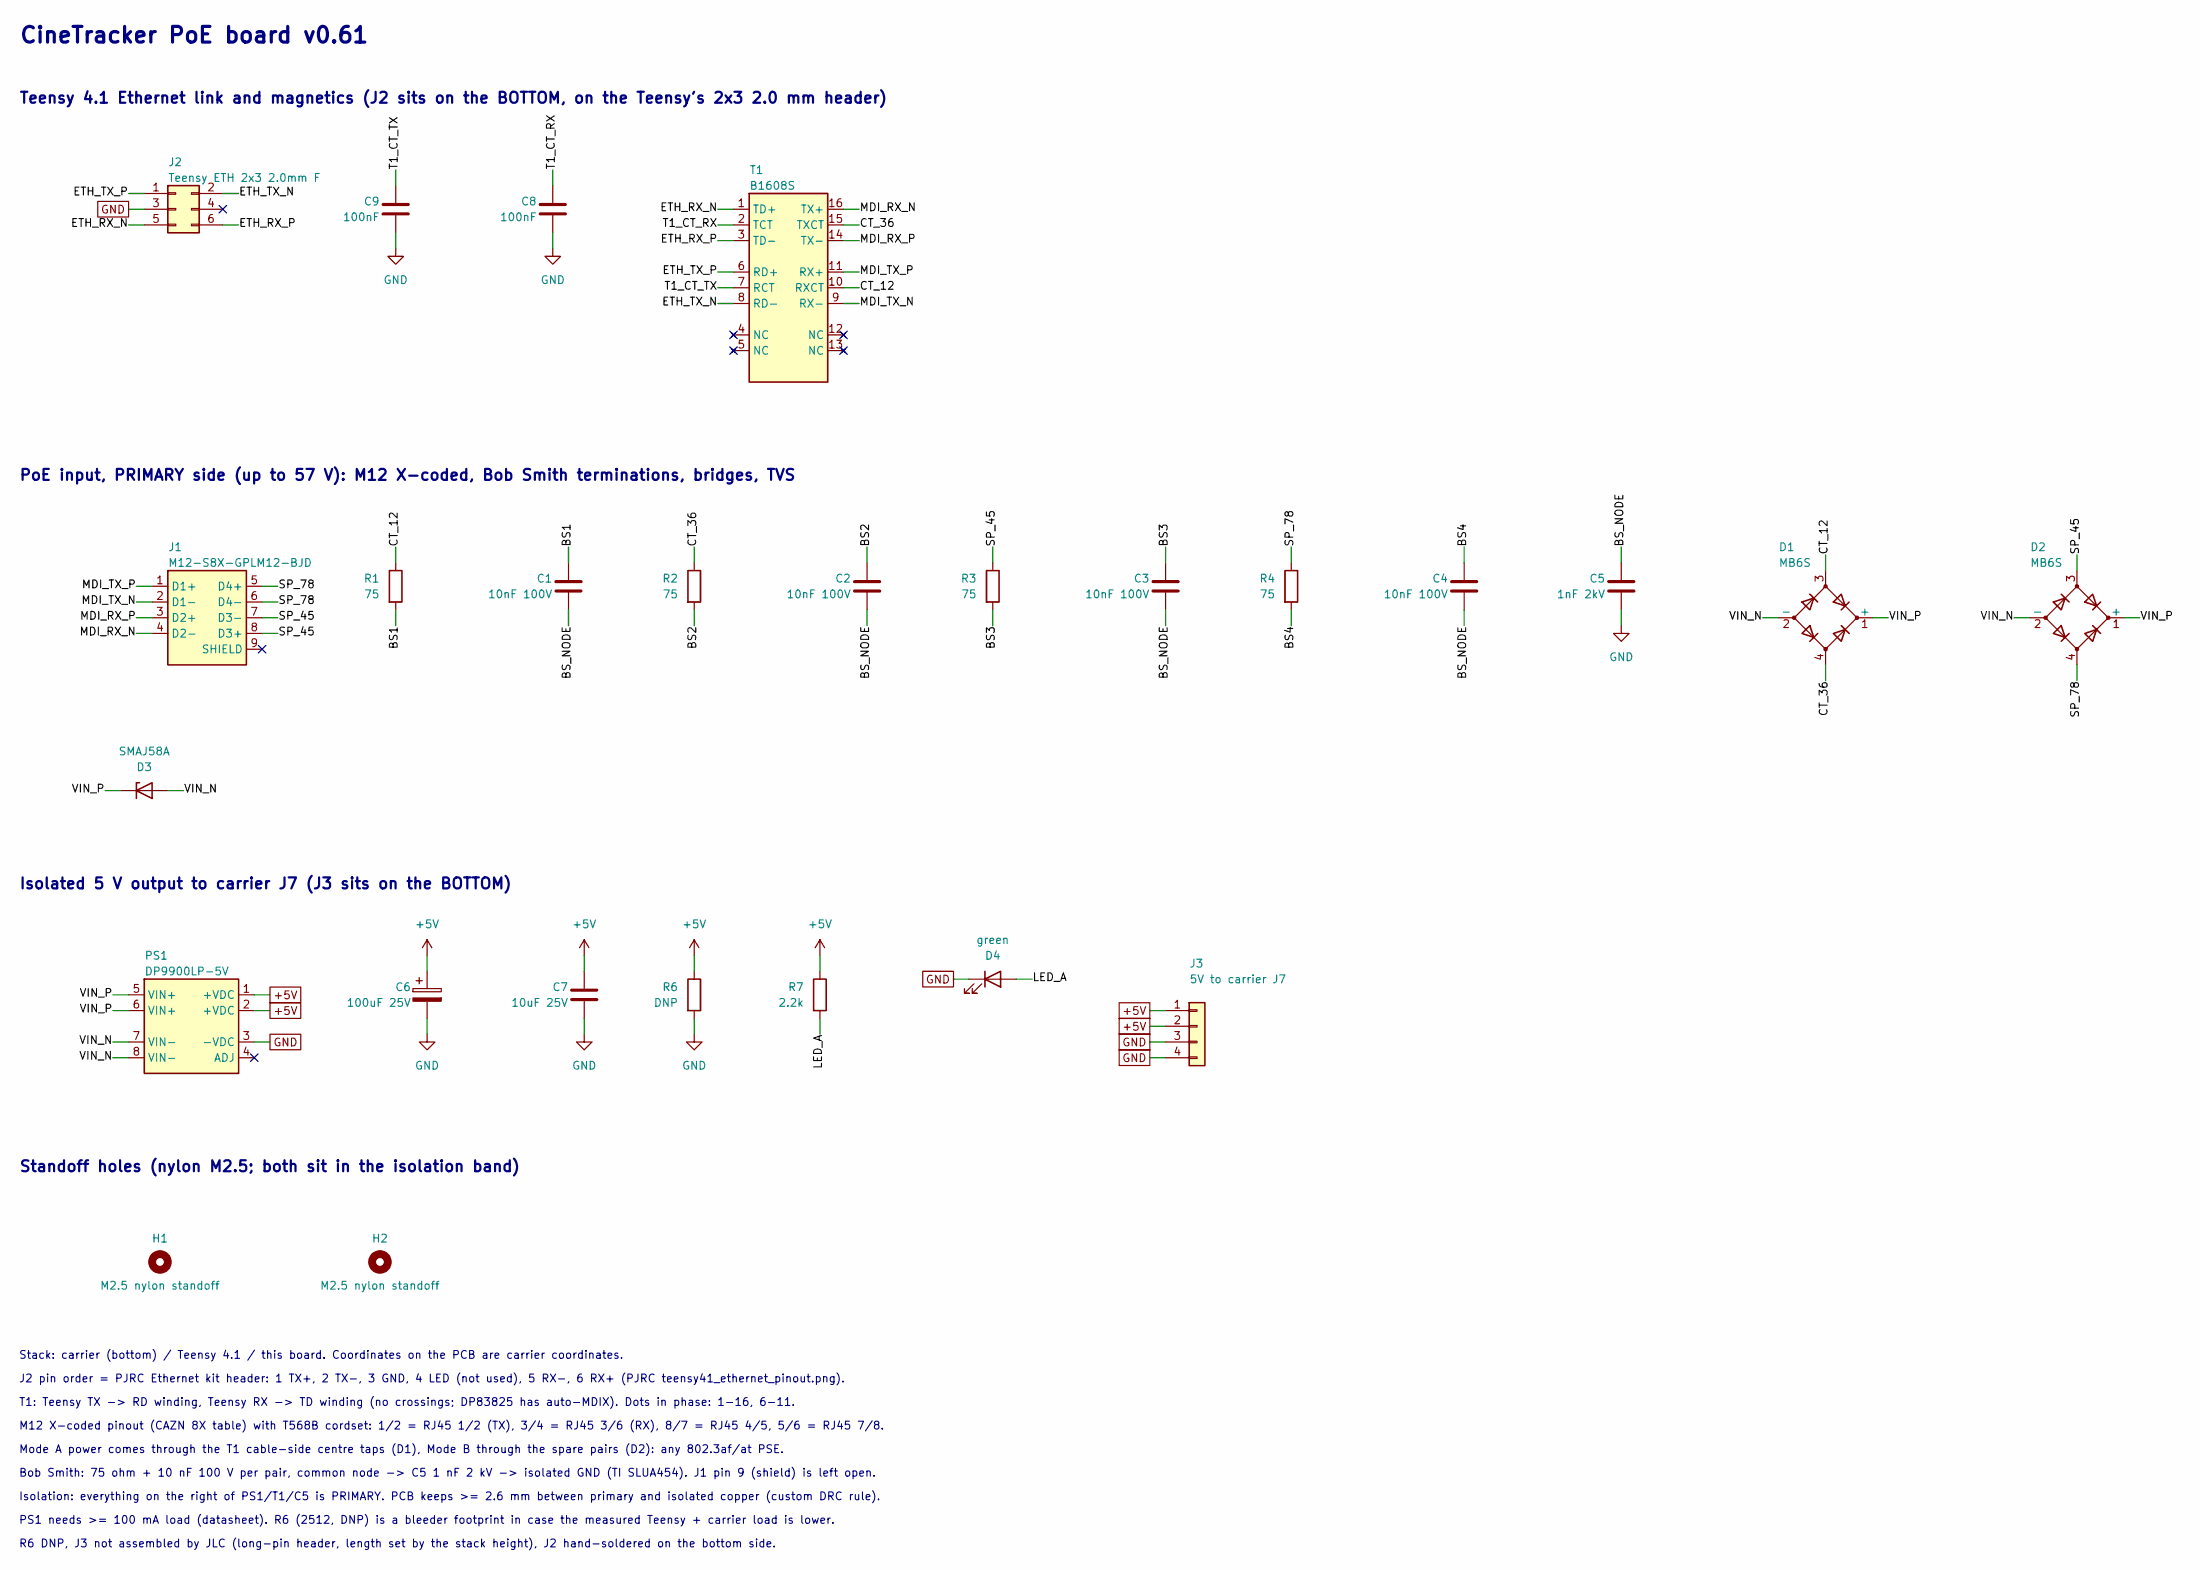
[picture p13: schematic cinetracker-poe.kicad_sch, CineTracker PoE board]

Parts:
C1, C2, C3, C4: 10nF 100V; C_0603_1608Metric; MPN CC0603KRX7R0BB103; LCSC C107059
C5: 1nF 2kV; C_1812_4532Metric; MPN CC1812KKX7RDBB102; LCSC C118019
C6: 100uF 25V; CP_Elec_6.3x5.4; MPN RST100UF25V004; LCSC C4747964
C7: 10uF 25V; C_0805_2012Metric; MPN CL21A106KAYNNNE; LCSC C15850
C8, C9: 100nF; C_0603_1608Metric; MPN CC0603KRX7R9BB104; LCSC C14663
D1, D2: MB6S; MBS_MDD; MPN MB6S; LCSC C2487
D3: SMAJ58A; D_SMA; MPN SMAJ58A; LCSC C2980408
D4: green; LED_0805_2012Metric; MPN KT-0805G; LCSC C2297
H1, H2: M2.5 nylon standoff; MountingHole_2.7mm_M2.5
J1: M12-S8X-GPLM12-BJD; M12_X8_F_RA_CAZN; MPN M12-S8X-GPLM12-BJD; LCSC C7423431
J2: Teensy ETH 2x3 2.0mm F; PinSocket_2x03_P2.00mm_Vertical; MPN 2005FV-2x3P; LCSC C18723065
J3: 5V to carrier J7; PinHeader_1x04_P2.54mm_Vertical
PS1: DP9900LP-5V; DP9900LP; MPN DP9900LP-5V; LCSC C5380108
R1, R2, R3, R4: 75; R_0603_1608Metric; MPN 0603WAF750JT5E; LCSC C4275
R6: DNP; R_2512_6332Metric
R7: 2.2k; R_0603_1608Metric; MPN 0603WAF2201T5E; LCSC C4190
T1: B1608S; MPN B1608S; LCSC C507596

Connections:
+5V: C6.1, C7.1, J3.1, J3.2, PS1.1 (+VDC), PS1.2 (+VDC), R6.1, R7.1
/BS1: C1.1, R1.2
/BS2: C2.1, R2.2
/BS3: C3.1, R3.2
/BS4: C4.1, R4.2
/BS_NODE: C1.2, C2.2, C3.2, C4.2, C5.1
/CT_12: D1.3, R1.1, T1.10 (RXCT)
/CT_36: D1.4, R2.1, T1.15 (TXCT)
/ETH_RX_N: J2.5, T1.1 (TD+)
/ETH_RX_P: J2.6, T1.3 (TD-)
/ETH_TX_N: J2.2, T1.8 (RD-)
/ETH_TX_P: J2.1, T1.6 (RD+)
/LED_A: D4.2 (A), R7.2
/MDI_RX_N: J1.4 (D2-), T1.16 (TX+)
/MDI_RX_P: J1.3 (D2+), T1.14 (TX-)
/MDI_TX_N: J1.2 (D1-), T1.9 (RX-)
/MDI_TX_P: J1.1 (D1+), T1.11 (RX+)
/SP_45: D2.3, J1.7 (D3-), J1.8 (D3+), R3.1
/SP_78: D2.4, J1.5 (D4+), J1.6 (D4-), R4.1
/T1_CT_RX: C8.1, T1.2 (TCT)
/T1_CT_TX: C9.1, T1.7 (RCT)
/VIN_N: D1.2 (-), D2.2 (-), D3.2 (A), PS1.7 (VIN-), PS1.8 (VIN-)
/VIN_P: D1.1 (+), D2.1 (+), D3.1 (K), PS1.5 (VIN+), PS1.6 (VIN+)
GND: C5.2, C6.2, C7.2, C8.2, C9.2, D4.1 (K), J2.3, J3.3, J3.4, PS1.3 (-VDC), R6.2

Notes on the sheet:
M12 X-coded pinout (CAZN 8X table) with T568B cordset: 1/2 = RJ45 1/2 (TX), 3/4 = RJ45 3/6 (RX), 8/7 = RJ45 4/5, 5/6 = RJ45 7/8.
R6 DNP, J3 not assembled by JLC (long-pin header, length set by the stack height), J2 hand-soldered on the bottom side.
Stack: carrier (bottom) / Teensy 4.1 / this board. Coordinates on the PCB are carrier coordinates.
Mode A power comes through the T1 cable-side centre taps (D1), Mode B through the spare pairs (D2): any 802.3af/at PSE.
Standoff holes (nylon M2.5; both sit in the isolation band)
Teensy 4.1 Ethernet link and magnetics (J2 sits on the BOTTOM, on the Teensy's 2x3 2.0 mm header)
Isolation: everything on the right of PS1/T1/C5 is PRIMARY. PCB keeps >= 2.6 mm between primary and isolated copper (custom DRC rule).
J2 pin order = PJRC Ethernet kit header: 1 TX+, 2 TX-, 3 GND, 4 LED (not used), 5 RX-, 6 RX+ (PJRC teensy41_ethernet_pinout.png).
CineTracker PoE board v0.61
PS1 needs >= 100 mA load (datasheet). R6 (2512, DNP) is a bleeder footprint in case the measured Teensy + carrier load is lower.
Isolated 5 V output to carrier J7 (J3 sits on the BOTTOM)
T1: Teensy TX -> RD winding, Teensy RX -> TD winding (no crossings; DP83825 has auto-MDIX). Dots in phase: 1-16, 6-11.
PoE input, PRIMARY side (up to 57 V): M12 X-coded, Bob Smith terminations, bridges, TVS
Bob Smith: 75 ohm + 10 nF 100 V per pair, common node -> C5 1 nF 2 kV -> isolated GND (TI SLUA454). J1 pin 9 (shield) is left open.

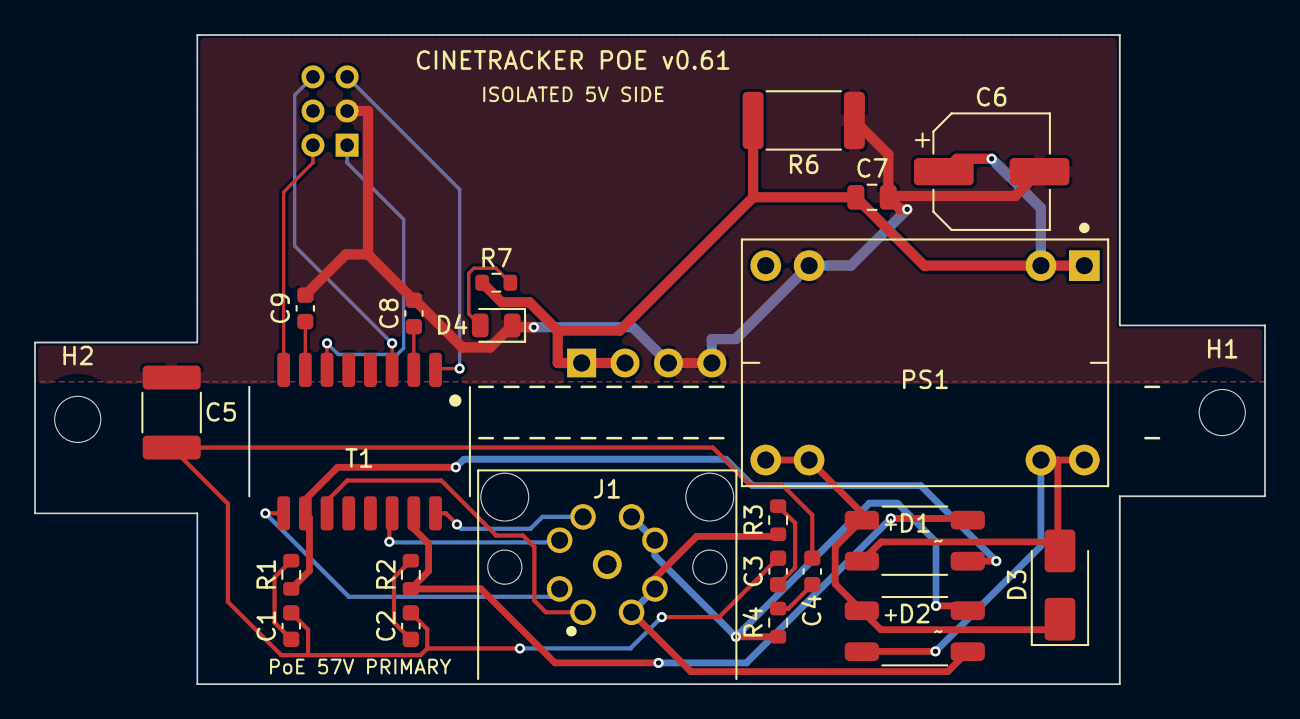
[picture p14: board cinetracker-poe.kicad_pcb from above]

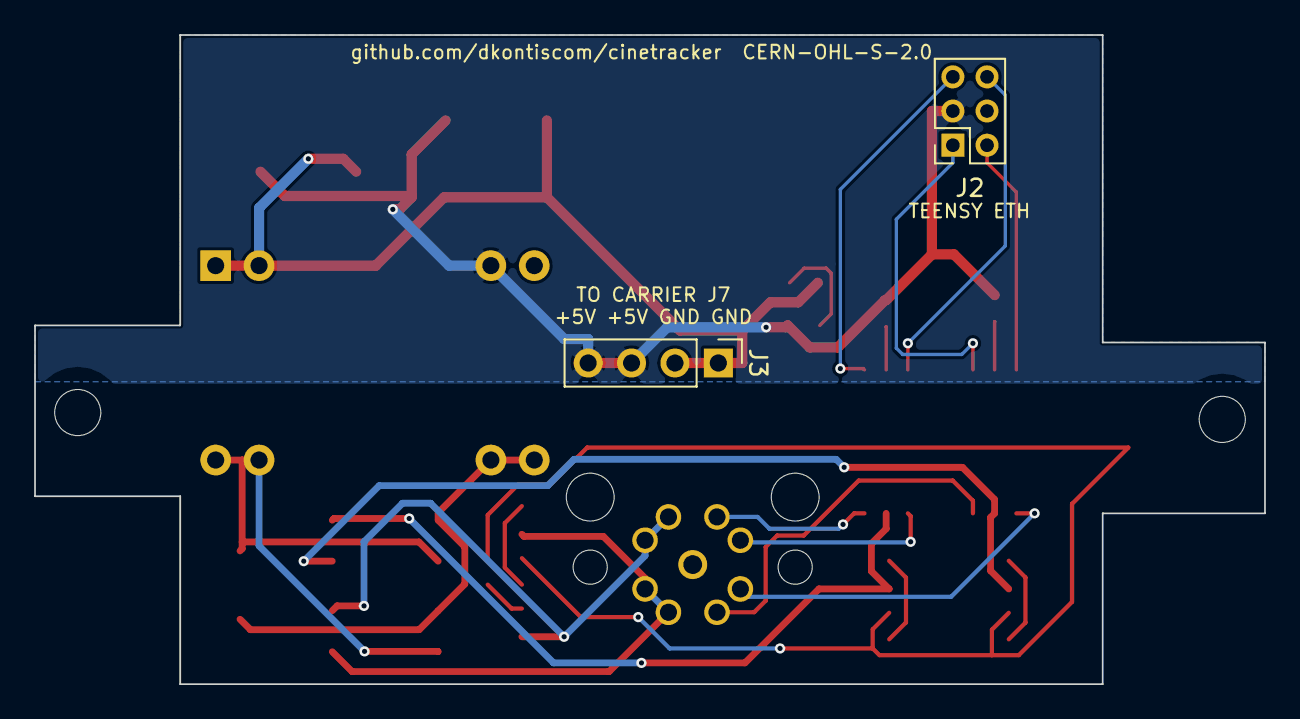
[picture p15: board cinetracker-poe.kicad_pcb from below]

Board: 2 copper layers, 72.0 x 38.0 mm, 26 parts (2 on the bottom side), 24 nets.
