dkontiscom/cinetracker/hardware/carrier/cinetracker-carrier.kicad_pcb

## KiCad design hardware/carrier/cinetracker-carrier.kicad_pcb (2026-10-11)

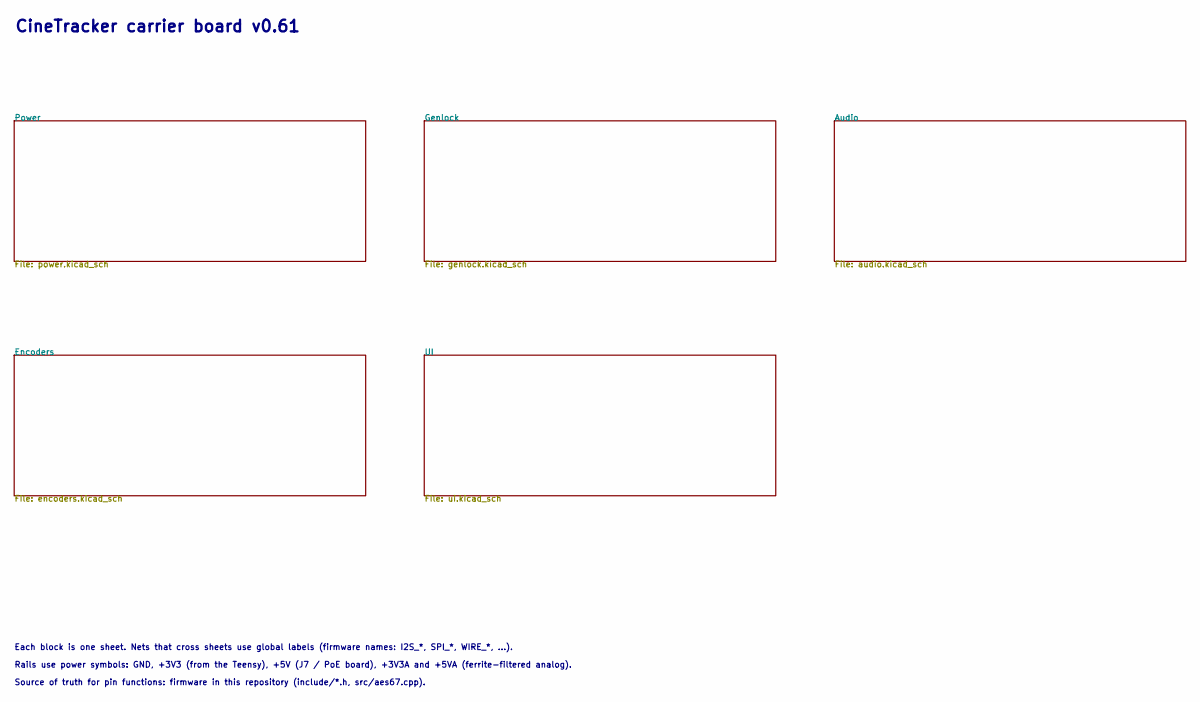
[picture p16: schematic cinetracker-carrier.kicad_sch, CineTracker carrier board]

Notes on the sheet:
Each block is one sheet. Nets that cross sheets use global labels (firmware names: I2S_*, SPI_*, WIRE_*, ...).
CineTracker carrier board v0.61
Rails use power symbols: GND, +3V3 (from the Teensy), +5V (J7 / PoE board), +3V3A and +5VA (ferrite-filtered analog).
Source of truth for pin functions: firmware in this repository (include/*.h, src/aes67.cpp).

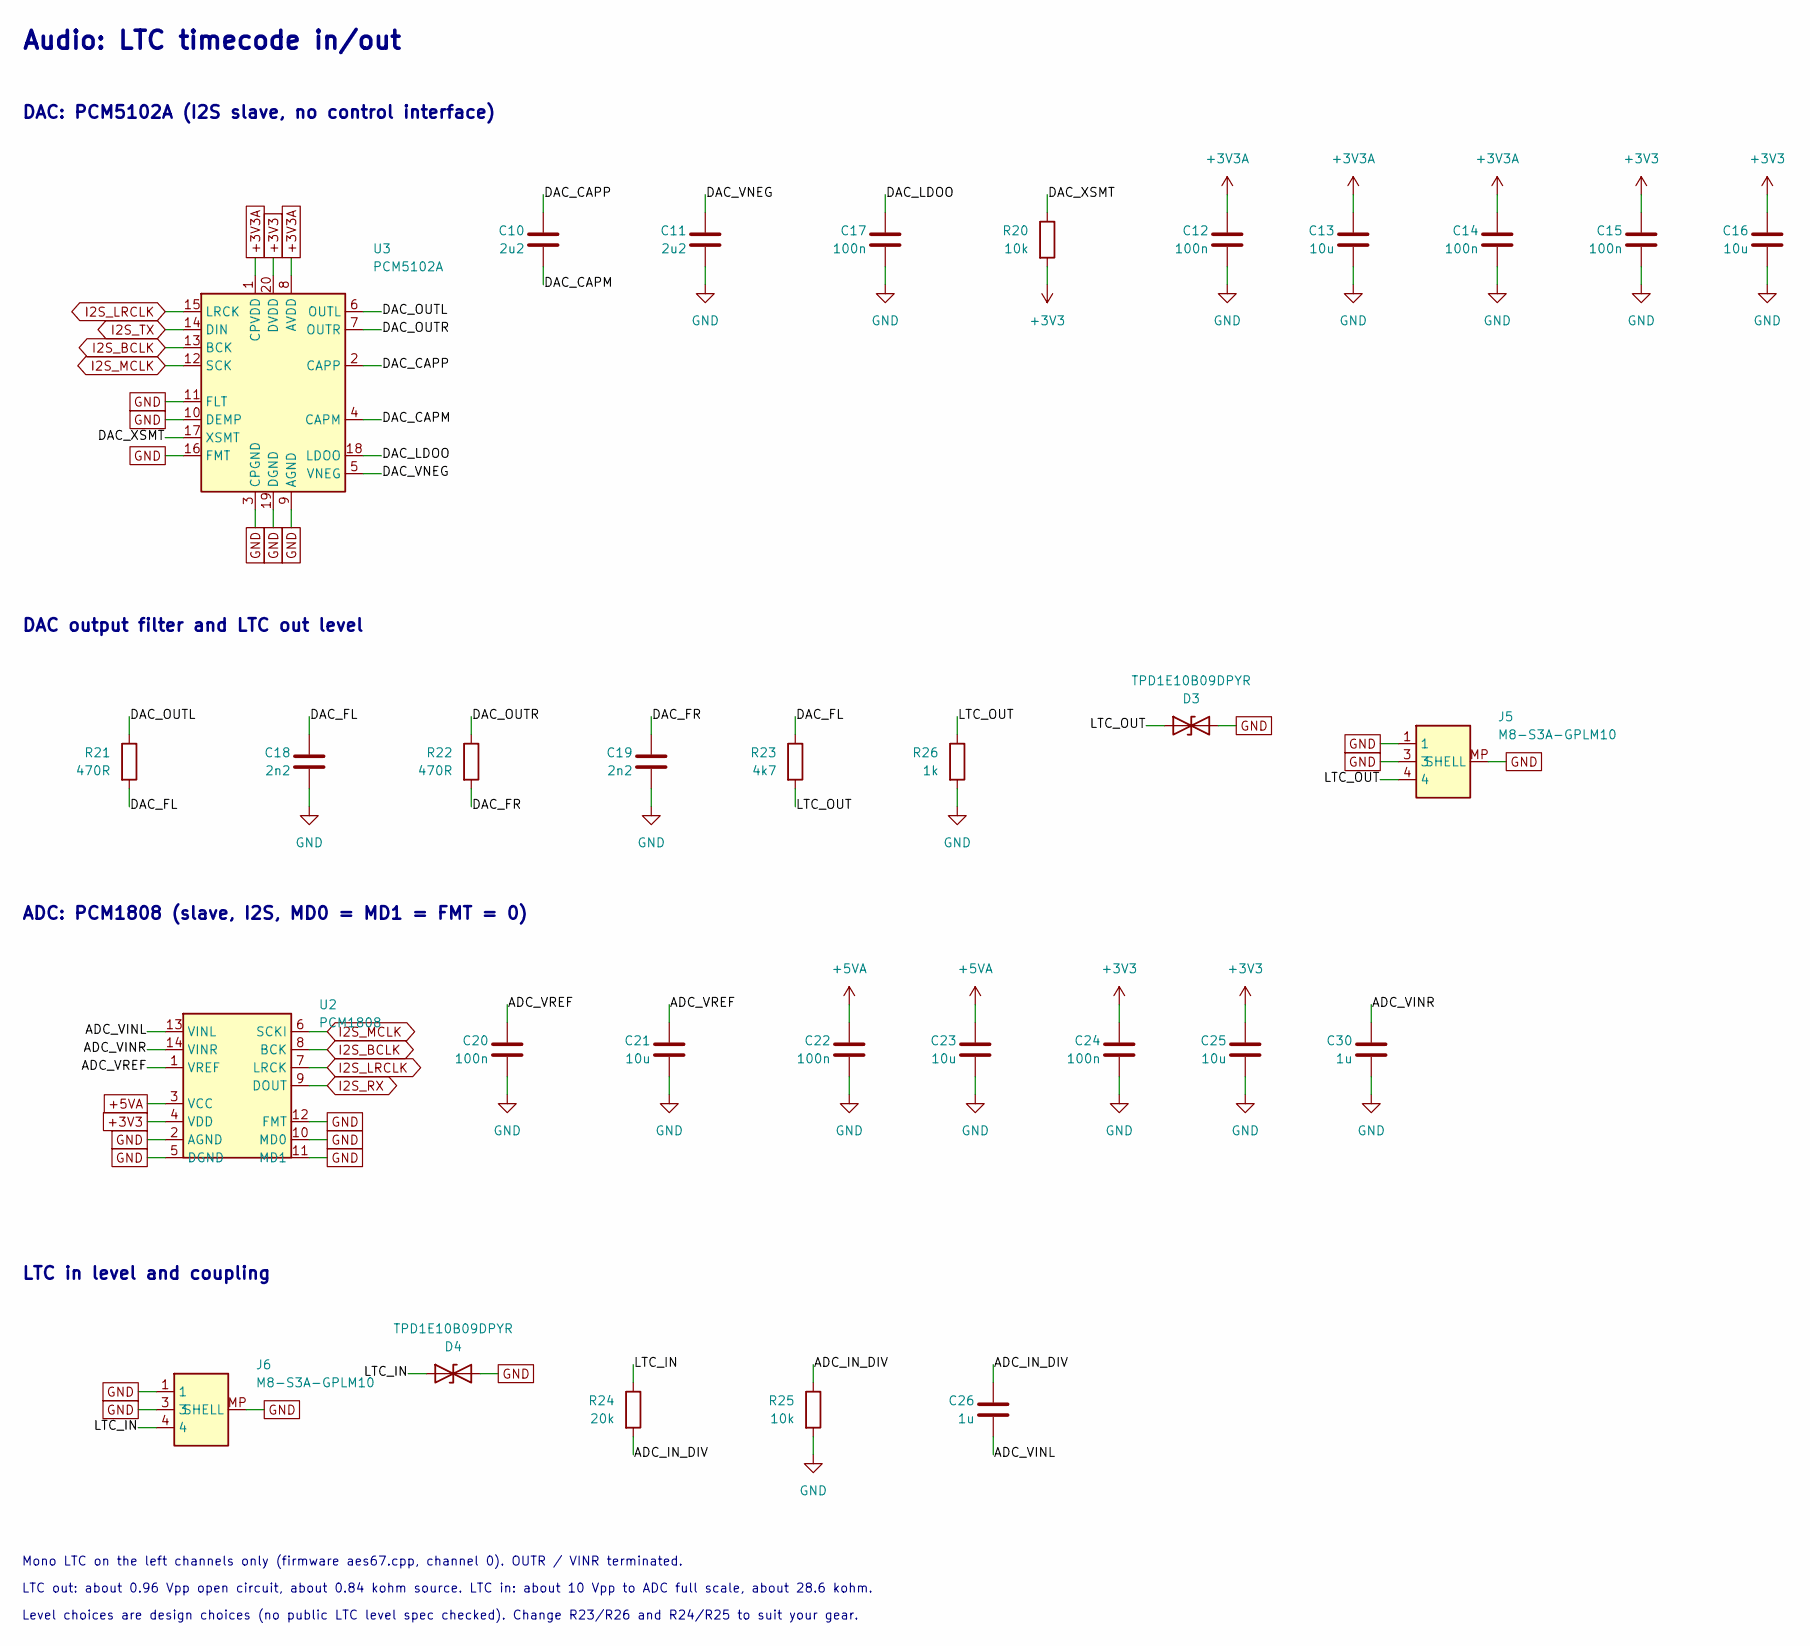
[picture p17: schematic audio.kicad_sch, CineTracker carrier: Audio: LTC timecode in/out]

Parts:
C10, C11: 2u2; C_0805_2012Metric; MPN CL21B225KAFNNNE; LCSC C19110
C12, C14, C15, C17, C20, C22, C24: 100n; C_0805_2012Metric; MPN CC0805KRX7R9BB104; LCSC C49678
C13, C16, C21, C23, C25: 10u; C_0805_2012Metric; MPN CL21A106KAYNNNE; LCSC C15850
C18, C19: 2n2; C_0805_2012Metric; MPN CL21C222JBFNNNE; LCSC C28260
C26, C30: 1u; C_0805_2012Metric; MPN CL21B105KBFNNNE; LCSC C28323
D3, D4: TPD1E10B09DPYR; TI_DPY0002A; MPN TPD1E10B09DPYR; LCSC C88031
J5, J6: M8-S3A-GPLM10; M8_3pin_F_RA_CAZN; MPN M8-S3A-GPLM10; LCSC C42931206
R20, R25: 10k; R_0805_2012Metric; MPN 0805W8F1002T5E; LCSC C17414
R21, R22: 470R; R_0805_2012Metric; MPN 0805W8F4700T5E; LCSC C17710
R23: 4k7; R_0805_2012Metric; MPN 0805W8F4701T5E; LCSC C17673
R24: 20k; R_0805_2012Metric; MPN 0805W8F2002T5E; LCSC C4328
R26: 1k; R_0805_2012Metric; MPN 0805W8F1001T5E; LCSC C17513
U2: PCM1808; TSSOP-14_4.4x5mm_P0.65mm; MPN PCM1808PWR; LCSC C55513
U3: PCM5102A; TSSOP-20_4.4x6.5mm_P0.65mm; MPN PCM5102APWR; LCSC C107671

Connections:
+3V3: C15.1, C16.1, C24.1, C25.1, R20.2, U2.4 (VDD), U3.20 (DVDD); also elsewhere on the board
+3V3A: C12.1, C13.1, C14.1, U3.1 (CPVDD), U3.8 (AVDD); also elsewhere on the board
+5VA: C22.1, C23.1, U2.3 (VCC); also elsewhere on the board
/Audio/ADC_IN_DIV: C26.1, R24.2, R25.1
/Audio/ADC_VINL: C26.2, U2.13 (VINL)
/Audio/ADC_VINR: C30.1, U2.14 (VINR)
/Audio/ADC_VREF: C20.1, C21.1, U2.1 (VREF)
/Audio/DAC_CAPM: C10.2, U3.4 (CAPM)
/Audio/DAC_CAPP: C10.1, U3.2 (CAPP)
/Audio/DAC_FL: C18.1, R21.2, R23.1
/Audio/DAC_FR: C19.1, R22.2
/Audio/DAC_LDOO: C17.1, U3.18 (LDOO)
/Audio/DAC_OUTL: R21.1, U3.6 (OUTL)
/Audio/DAC_OUTR: R22.1, U3.7 (OUTR)
/Audio/DAC_VNEG: C11.1, U3.5 (VNEG)
/Audio/DAC_XSMT: R20.1, U3.17 (XSMT)
/Audio/LTC_IN: D4.1 (A1), J6.4, R24.1
/Audio/LTC_OUT: D3.1 (A1), J5.4, R23.2, R26.1
GND: C11.2, C12.2, C13.2, C14.2, C15.2, C16.2, C17.2, C18.2, C19.2, C20.2, C21.2, C22.2, C23.2, C24.2, C25.2, C30.2, D3.2 (A2), D4.2 (A2), J5.1, J5.3, J5.MP (SHELL), J6.1, J6.3, J6.MP (SHELL), R25.2, R26.2, U2.2 (AGND), U2.5 (DGND), U2.10 (MD0), U2.11 (MD1), U2.12 (FMT), U3.3 (CPGND), U3.9 (AGND), U3.10 (DEMP), U3.11 (FLT), U3.16 (FMT), U3.19 (DGND); also elsewhere on the board
I2S_BCLK: U2.8 (BCK), U3.13 (BCK); also elsewhere on the board
I2S_LRCLK: U2.7 (LRCK), U3.15 (LRCK); also elsewhere on the board
I2S_MCLK: U2.6 (SCKI), U3.12 (SCK); also elsewhere on the board
I2S_RX: U2.9 (DOUT); also elsewhere on the board
I2S_TX: U3.14 (DIN); also elsewhere on the board

Notes on the sheet:
Mono LTC on the left channels only (firmware aes67.cpp, channel 0). OUTR / VINR terminated.
Level choices are design choices (no public LTC level spec checked). Change R23/R26 and R24/R25 to suit your gear.
DAC output filter and LTC out level
LTC out: about 0.96 Vpp open circuit, about 0.84 kohm source. LTC in: about 10 Vpp to ADC full scale, about 28.6 kohm.
LTC in level and coupling
ADC: PCM1808 (slave, I2S, MD0 = MD1 = FMT = 0)
DAC: PCM5102A (I2S slave, no control interface)
Audio: LTC timecode in/out

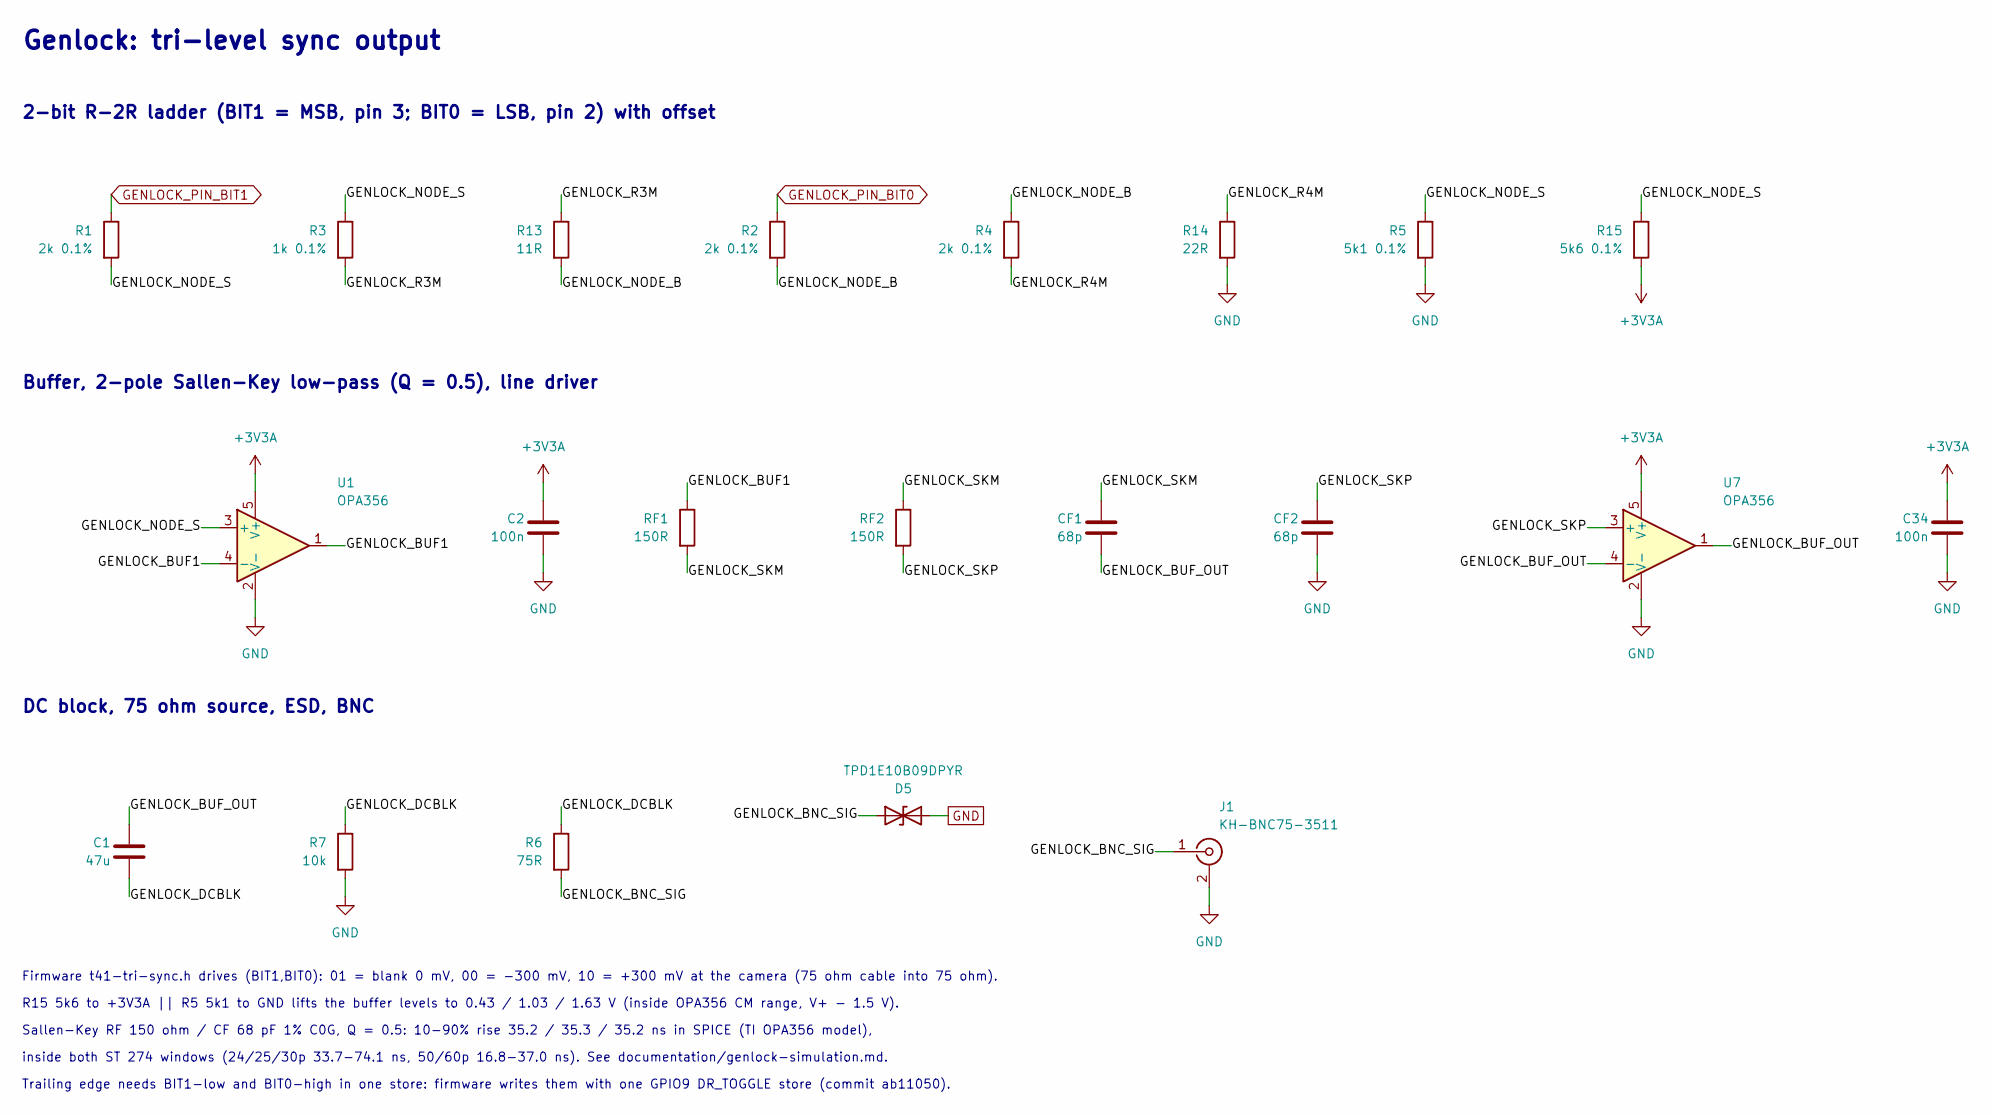
[picture p18: schematic genlock.kicad_sch, CineTracker carrier: Genlock: tri-level sync output]

Parts:
C1: 47u; C_1206_3216Metric; MPN CL31A476MPHNNNE; LCSC C96123
C2, C34: 100n; C_0805_2012Metric; MPN CC0805KRX7R9BB104; LCSC C49678
CF1, CF2: 68p; C_0805_2012Metric; MPN CC0805FRNPO9BN680; LCSC C541517
D5: TPD1E10B09DPYR; TI_DPY0002A; MPN TPD1E10B09DPYR; LCSC C88031
J1: KH-BNC75-3511; BNC75_RA_KH3511; MPN KH-BNC75-3511; LCSC C2837588
R1, R2, R4: 2k 0.1%; R_0805_2012Metric; MPN RT0805BRE072KL; LCSC C706274
R3: 1k 0.1%; R_0805_2012Metric; MPN RT0805BRD071KL; LCSC C110774
R5: 5k1 0.1%; R_0805_2012Metric; MPN RT0805BRD075K1L; LCSC C122968
R6: 75R; R_0805_2012Metric; MPN RC0805FR-0775RL; LCSC C141697
R7: 10k; R_0805_2012Metric; MPN 0805W8F1002T5E; LCSC C17414
R13: 11R; R_0805_2012Metric; MPN 0805W8F110JT5E; LCSC C17430
R14: 22R; R_0805_2012Metric; MPN 0805W8F220JT5E; LCSC C17561
R15: 5k6 0.1%; R_0805_2012Metric; MPN ERA6AEB562V; LCSC C445654
RF1, RF2: 150R; R_0805_2012Metric; MPN 0805W8F1500T5E; LCSC C17471
U1, U7: OPA356; SOT-23-5; MPN OPA356AIDBVR; LCSC C183100

Connections:
+3V3A: C2.1, C34.1, R15.2, U1.5 (V+), U7.5 (V+); also elsewhere on the board
/Genlock/GENLOCK_BNC_SIG: D5.1 (A1), J1.1 (In), R6.2
/Genlock/GENLOCK_BUF1: RF1.1, U1.1, U1.4 (-)
/Genlock/GENLOCK_BUF_OUT: C1.1, CF1.2, U7.1, U7.4 (-)
/Genlock/GENLOCK_DCBLK: C1.2, R6.1, R7.1
/Genlock/GENLOCK_NODE_B: R2.2, R4.1, R13.2
/Genlock/GENLOCK_NODE_S: R1.2, R3.1, R5.1, R15.1, U1.3 (+)
/Genlock/GENLOCK_R3M: R3.2, R13.1
/Genlock/GENLOCK_R4M: R4.2, R14.1
/Genlock/GENLOCK_SKM: CF1.1, RF1.2, RF2.1
/Genlock/GENLOCK_SKP: CF2.1, RF2.2, U7.3 (+)
GENLOCK_PIN_BIT0: R2.1; also elsewhere on the board
GENLOCK_PIN_BIT1: R1.1; also elsewhere on the board
GND: C2.2, C34.2, CF2.2, D5.2 (A2), J1.2 (Ext), R5.2, R7.2, R14.2, U1.2 (V-), U7.2 (V-); also elsewhere on the board

Notes on the sheet:
R15 5k6 to +3V3A || R5 5k1 to GND lifts the buffer levels to 0.43 / 1.03 / 1.63 V (inside OPA356 CM range, V+ - 1.5 V).
Genlock: tri-level sync output
2-bit R-2R ladder (BIT1 = MSB, pin 3; BIT0 = LSB, pin 2) with offset
inside both ST 274 windows (24/25/30p 33.7-74.1 ns, 50/60p 16.8-37.0 ns). See documentation/genlock-simulation.md.
Buffer, 2-pole Sallen-Key low-pass (Q = 0.5), line driver
Sallen-Key RF 150 ohm / CF 68 pF 1% C0G, Q = 0.5: 10-90% rise 35.2 / 35.3 / 35.2 ns in SPICE (TI OPA356 model),
DC block, 75 ohm source, ESD, BNC
Firmware t41-tri-sync.h drives (BIT1,BIT0): 01 = blank 0 mV, 00 = -300 mV, 10 = +300 mV at the camera (75 ohm cable into 75 ohm).
Trailing edge needs BIT1-low and BIT0-high in one store: firmware writes them with one GPIO9 DR_TOGGLE store (commit ab11050).

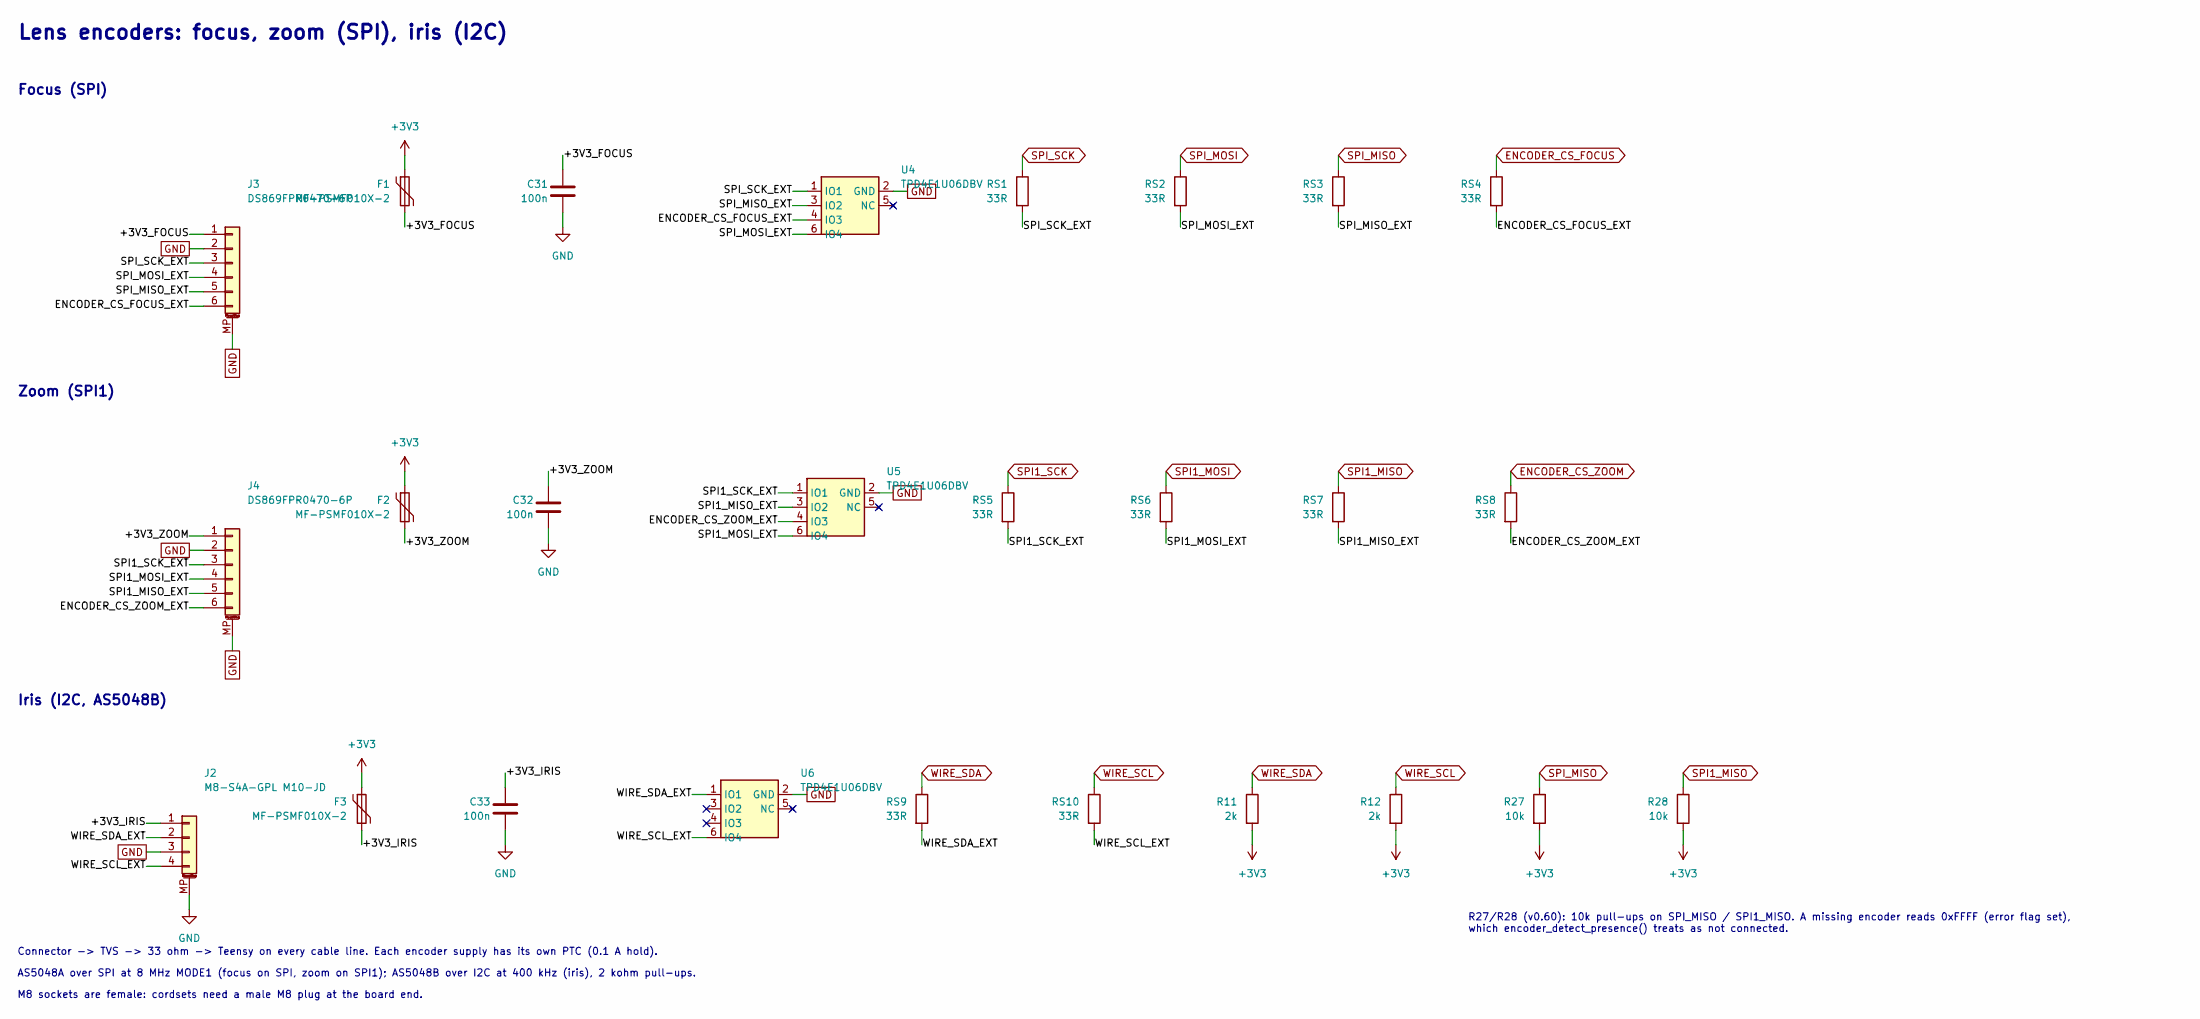
[picture p19: schematic encoders.kicad_sch, CineTracker carrier: Lens encoders: focus, zoom (SPI), iris…]

Parts:
C31, C32, C33: 100n; C_0805_2012Metric; MPN CC0805KRX7R9BB104; LCSC C49678
F1, F2, F3: MF-PSMF010X-2; Fuse_0805_2012Metric; MPN MF-PSMF010X-2; LCSC C116171
J2: M8-S4A-GPL M10-JD; M8_4pin_F_RA_CAZN; MPN M8-S4A-GPL M10-JD; LCSC C19108970
J3, J4: DS869FPR0470-6P; M8_6pin_F_RA_DOSIN; MPN DS869FPR0470-6P; LCSC C42395389
R11, R12: 2k; R_0805_2012Metric; MPN 0805W8F2001T5E; LCSC C17604
R27, R28: 10k; R_0805_2012Metric; MPN 0805W8F1002T5E; LCSC C17414
RS1, RS2, RS3, RS4, RS5, RS6, RS7, RS8, RS9, RS10: 33R; R_0805_2012Metric; MPN 0805W8F330JT5E; LCSC C17634
U4, U5, U6: TPD4E1U06DBV; SOT-23-6; MPN TPD4E1U06DBVR; LCSC C124691

Connections:
+3V3: F1.1, F2.1, F3.1, R11.2, R12.2, R27.2, R28.2; also elsewhere on the board
/Encoders/+3V3_FOCUS: C31.1, F1.2, J3.1
/Encoders/+3V3_IRIS: C33.1, F3.2, J2.1
/Encoders/+3V3_ZOOM: C32.1, F2.2, J4.1
/Encoders/ENCODER_CS_FOCUS_EXT: J3.6, RS4.2, U4.4 (IO3)
/Encoders/ENCODER_CS_ZOOM_EXT: J4.6, RS8.2, U5.4 (IO3)
/Encoders/SPI1_MISO_EXT: J4.5, RS7.2, U5.3 (IO2)
/Encoders/SPI1_MOSI_EXT: J4.4, RS6.2, U5.6 (IO4)
/Encoders/SPI1_SCK_EXT: J4.3, RS5.2, U5.1 (IO1)
/Encoders/SPI_MISO_EXT: J3.5, RS3.2, U4.3 (IO2)
/Encoders/SPI_MOSI_EXT: J3.4, RS2.2, U4.6 (IO4)
/Encoders/SPI_SCK_EXT: J3.3, RS1.2, U4.1 (IO1)
/Encoders/WIRE_SCL_EXT: J2.4, RS10.2, U6.6 (IO4)
/Encoders/WIRE_SDA_EXT: J2.2, RS9.2, U6.1 (IO1)
ENCODER_CS_FOCUS: RS4.1; also elsewhere on the board
ENCODER_CS_ZOOM: RS8.1; also elsewhere on the board
GND: C31.2, C32.2, C33.2, J2.3, J2.MP (MountPin), J3.2, J3.MP (MountPin), J4.2, J4.MP (MountPin), U4.2 (GND), U5.2 (GND), U6.2 (GND); also elsewhere on the board
SPI1_MISO: R28.1, RS7.1; also elsewhere on the board
SPI1_MOSI: RS6.1; also elsewhere on the board
SPI1_SCK: RS5.1; also elsewhere on the board
SPI_MISO: R27.1, RS3.1; also elsewhere on the board
SPI_MOSI: RS2.1; also elsewhere on the board
SPI_SCK: RS1.1; also elsewhere on the board
WIRE_SCL: R12.1, RS10.1; also elsewhere on the board
WIRE_SDA: R11.1, RS9.1; also elsewhere on the board

Notes on the sheet:
Lens encoders: focus, zoom (SPI), iris (I2C)
M8 sockets are female: cordsets need a male M8 plug at the board end.
Focus (SPI)
R27/R28 (v0.60): 10k pull-ups on SPI_MISO / SPI1_MISO. A missing encoder reads 0xFFFF (error flag set), which encoder_detect_presence() treats as not connected.
Iris (I2C, AS5048B)
AS5048A over SPI at 8 MHz MODE1 (focus on SPI, zoom on SPI1); AS5048B over I2C at 400 kHz (iris), 2 kohm pull-ups.
Zoom (SPI1)
Connector -> TVS -> 33 ohm -> Teensy on every cable line. Each encoder supply has its own PTC (0.1 A hold).
