dkontiscom/cinetracker/hardware/carrier/cinetracker-carrier.kicad_pcb

## KiCad design hardware/carrier/cinetracker-carrier.kicad_pcb (continued)

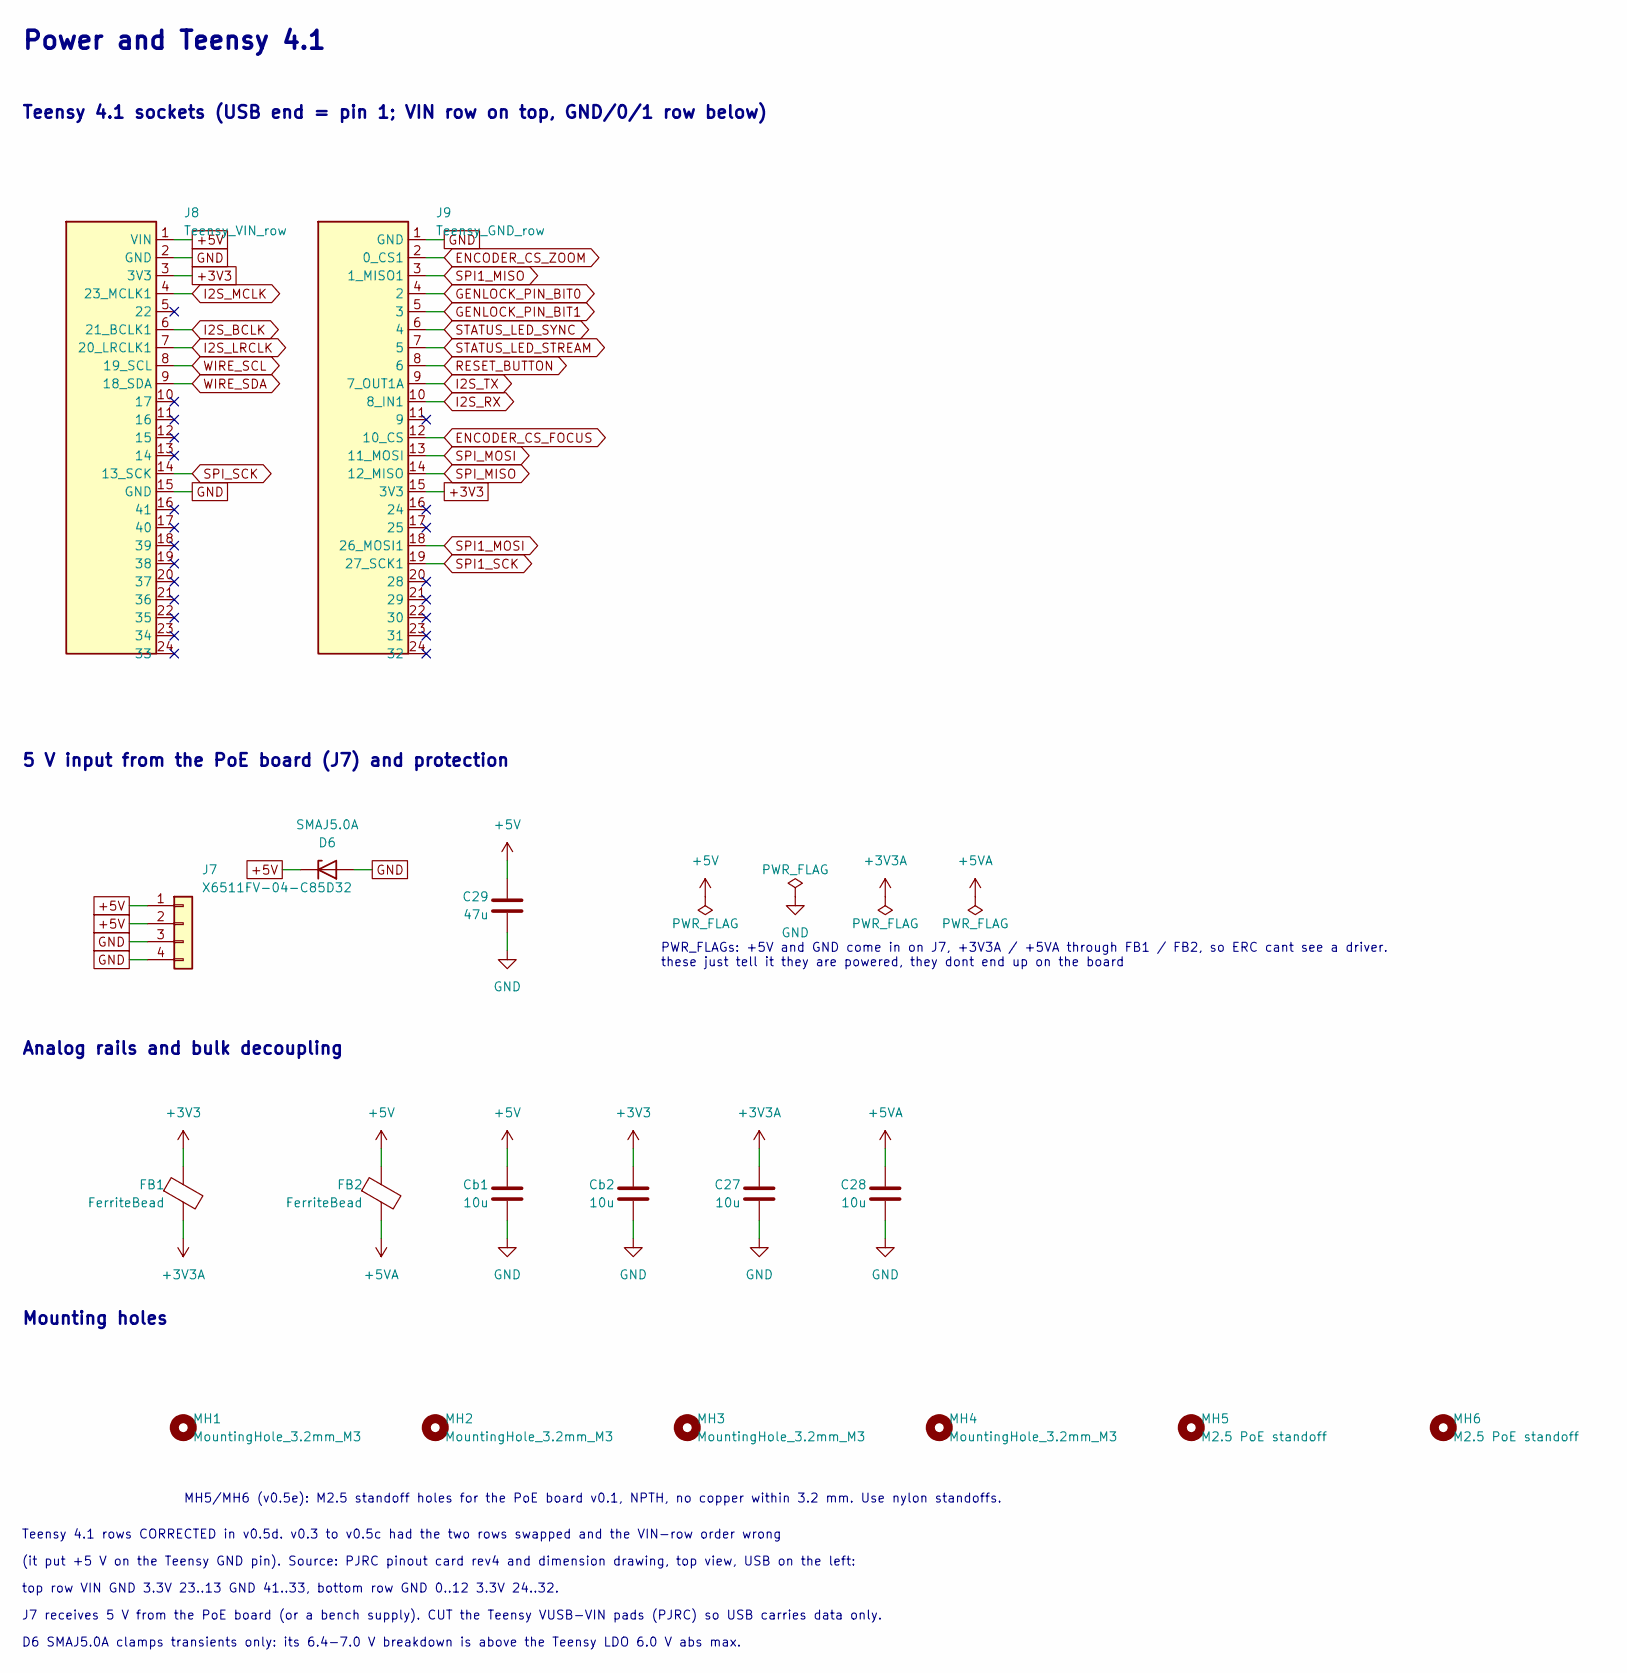
[picture p20: schematic power.kicad_sch, CineTracker carrier: Power and Teensy 4.1]

Parts:
C27, C28: 10u; C_0805_2012Metric; MPN CL21A106KAYNNNE; LCSC C15850
C29: 47u; C_1206_3216Metric; MPN CL31A476MPHNNNE; LCSC C96123
Cb1, Cb2: 10u; C_0805_2012Metric; MPN CL21A106KAYNNNE; LCSC C15850
D6: SMAJ5.0A; D_SMA; MPN SMAJ5.0A; LCSC C83329
FB1, FB2: FerriteBead; L_0805_2012Metric; MPN GZ2012D601TF; LCSC C1017
J7: X6511FV-04-C85D32; PinSocket_1x04_P2.54mm_Vertical; MPN X6511FV-04-C85D32; LCSC C718241
J8: Teensy_VIN_row; PinSocket_1x24_P2.54mm_Vertical; MPN X6511FV-24-C85D32; LCSC C2883741
J9: Teensy_GND_row; PinSocket_1x24_P2.54mm_Vertical; MPN X6511FV-24-C85D32; LCSC C2883741
MH1, MH2, MH3, MH4: MountingHole_3.2mm_M3
MH5, MH6: M2.5 PoE standoff; MountingHole_2.7mm_M2.5

Connections:
+3V3: Cb2.1, FB1.1, J8.3 (3V3), J9.15 (3V3); also elsewhere on the board
+3V3A: C27.1, FB1.2; also elsewhere on the board
+5V: C29.1, Cb1.1, D6.1 (K), FB2.1, J7.1, J7.2, J8.1 (VIN)
+5VA: C28.1, FB2.2; also elsewhere on the board
ENCODER_CS_FOCUS: J9.12 (10_CS); also elsewhere on the board
ENCODER_CS_ZOOM: J9.2 (0_CS1); also elsewhere on the board
GENLOCK_PIN_BIT0: J9.4 (2); also elsewhere on the board
GENLOCK_PIN_BIT1: J9.5 (3); also elsewhere on the board
GND: C27.2, C28.2, C29.2, Cb1.2, Cb2.2, D6.2 (A), J7.3, J7.4, J8.2 (GND), J8.15 (GND), J9.1 (GND); also elsewhere on the board
I2S_BCLK: J8.6 (21_BCLK1); also elsewhere on the board
I2S_LRCLK: J8.7 (20_LRCLK1); also elsewhere on the board
I2S_MCLK: J8.4 (23_MCLK1); also elsewhere on the board
I2S_RX: J9.10 (8_IN1); also elsewhere on the board
I2S_TX: J9.9 (7_OUT1A); also elsewhere on the board
RESET_BUTTON: J9.8 (6); also elsewhere on the board
SPI1_MISO: J9.3 (1_MISO1); also elsewhere on the board
SPI1_MOSI: J9.18 (26_MOSI1); also elsewhere on the board
SPI1_SCK: J9.19 (27_SCK1); also elsewhere on the board
SPI_MISO: J9.14 (12_MISO); also elsewhere on the board
SPI_MOSI: J9.13 (11_MOSI); also elsewhere on the board
SPI_SCK: J8.14 (13_SCK); also elsewhere on the board
STATUS_LED_STREAM: J9.7 (5); also elsewhere on the board
STATUS_LED_SYNC: J9.6 (4); also elsewhere on the board
WIRE_SCL: J8.8 (19_SCL); also elsewhere on the board
WIRE_SDA: J8.9 (18_SDA); also elsewhere on the board

Notes on the sheet:
Teensy 4.1 rows CORRECTED in v0.5d. v0.3 to v0.5c had the two rows swapped and the VIN-row order wrong
(it put +5 V on the Teensy GND pin). Source: PJRC pinout card rev4 and dimension drawing, top view, USB on the left:
Power and Teensy 4.1
J7 receives 5 V from the PoE board (or a bench supply). CUT the Teensy VUSB-VIN pads (PJRC) so USB carries data only.
Teensy 4.1 sockets (USB end = pin 1; VIN row on top, GND/0/1 row below)
Analog rails and bulk decoupling
top row VIN GND 3.3V 23..13 GND 41..33, bottom row GND 0..12 3.3V 24..32.
MH5/MH6 (v0.5e): M2.5 standoff holes for the PoE board v0.1, NPTH, no copper within 3.2 mm. Use nylon standoffs.
5 V input from the PoE board (J7) and protection
Mounting holes
D6 SMAJ5.0A clamps transients only: its 6.4-7.0 V breakdown is above the Teensy LDO 6.0 V abs max.
PWR_FLAGs: +5V and GND come in on J7, +3V3A / +5VA through FB1 / FB2, so ERC cant see a driver. these just tell it they are powered, they dont end up on the board

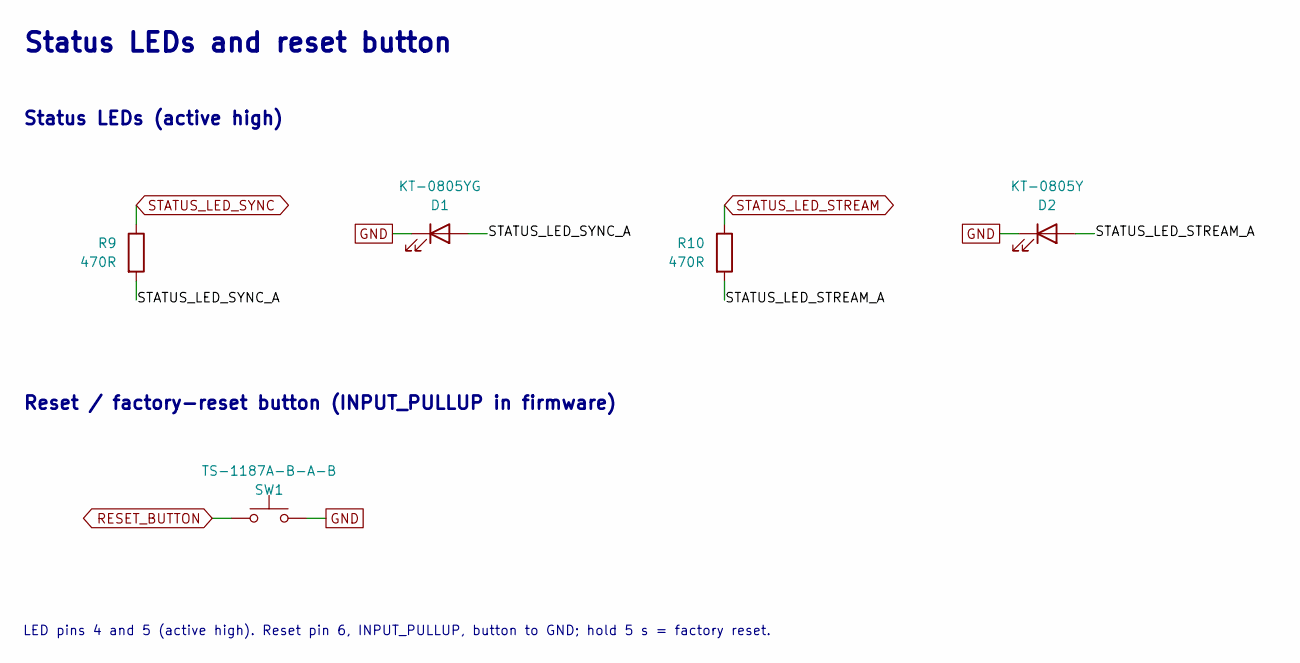
[picture p21: schematic ui.kicad_sch, CineTracker carrier: Status LEDs and reset button]

Parts:
D1: KT-0805YG; LED_0805_2012Metric; MPN KT-0805YG; LCSC C2292
D2: KT-0805Y; LED_0805_2012Metric; MPN KT-0805Y; LCSC C2296
R9, R10: 470R; R_0805_2012Metric; MPN 0805W8F4700T5E; LCSC C17710
SW1: TS-1187A-B-A-B; SW_Push_1P1T_XKB_TS-1187A; MPN TS-1187A-B-A-B; LCSC C318884

Connections:
/UI/STATUS_LED_STREAM_A: D2.2 (A), R10.2
/UI/STATUS_LED_SYNC_A: D1.2 (A), R9.2
GND: D1.1 (K), D2.1 (K), SW1.2; also elsewhere on the board
RESET_BUTTON: SW1.1; also elsewhere on the board
STATUS_LED_STREAM: R10.1; also elsewhere on the board
STATUS_LED_SYNC: R9.1; also elsewhere on the board

Notes on the sheet:
Reset / factory-reset button (INPUT_PULLUP in firmware)
Status LEDs and reset button
Status LEDs (active high)
LED pins 4 and 5 (active high). Reset pin 6, INPUT_PULLUP, button to GND; hold 5 s = factory reset.

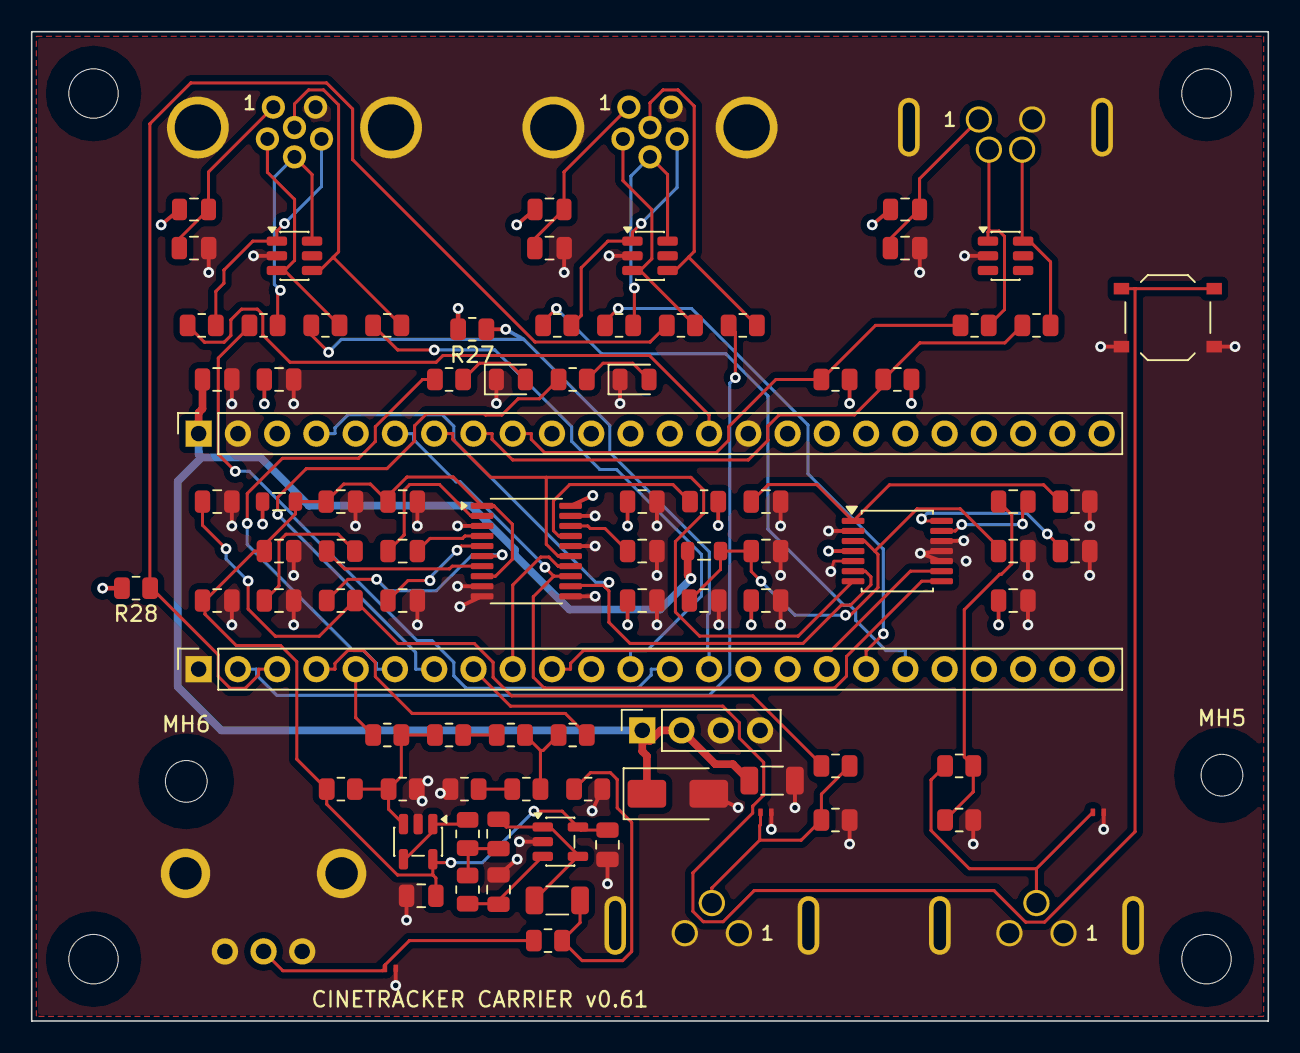
[picture p22: board cinetracker-carrier.kicad_pcb from above]

Board: 4 copper layers, 80.0 x 64.0 mm, 100 parts (0 on the bottom side), 65 nets.
