dkontiscom/cinetracker/include/math_engine.h

#pragma once

#include <Arduino.h>

#define AS5048_MAX_ANGLE 16383
#define MEDIAN_FILTER_SIZE 5
#define EMA_ALPHA_SHIFT 3
#define ENCODER_DEADBAND 2
#define KALMAN_Q 0.001f
#define KALMAN_R 0.1f
#define KALMAN_P_INITIAL 1.0f

enum FilterType {
  FILTER_NONE = 0,
  FILTER_EMA = 1,
  FILTER_MEDIAN = 2,
  FILTER_KALMAN = 3,
};

struct EncoderState {
  uint16_t raw_angle;
  // raw_angle never wraps into this its the live count since boot deltas
  // between calibration points are taken from here not the wrapped value
  int32_t unwrapped_angle;
  int32_t filtered_angle;
  int32_t normalized_angle;
  int16_t velocity;

  int32_t cal_min;
  int32_t cal_max;
  int32_t cal_range;
  int32_t original_cal_min;
  int32_t original_cal_max;

  bool overshoot_detected;
  uint8_t direction;
  uint16_t noise_floor;

  bool ema_initialized;
  float ema_state;

  int32_t median_buffer[MEDIAN_FILTER_SIZE];
  uint8_t median_index;

  bool kalman_initialized;
  float kalman_x;
  float kalman_p;
  float kalman_q;
  float kalman_r;

  uint8_t filter_type;

  uint32_t sample_count;
  uint16_t max_velocity;
  uint32_t update_timestamp;

  uint8_t encoder_id;
  uint8_t enabled;
  uint8_t calibrated;
  uint8_t connected;
};

uint16_t normalize_angle_14bit(uint16_t angle);
int16_t angle_distance(uint16_t from, uint16_t to);
uint16_t apply_deadband(uint16_t current, uint16_t previous, uint16_t threshold);

int32_t ema_filter(EncoderState *state, int32_t input);
int32_t median_filter(EncoderState *state, int32_t input);
int32_t kalman_filter(EncoderState *state, int32_t measurement);

void handle_boundary_overshoot(EncoderState *state, int32_t angle);
void math_process_angle(EncoderState *state, uint16_t raw_angle, int32_t unwrapped_angle);
void process_encoder_sample(EncoderState *state, uint16_t raw_angle, int32_t unwrapped_angle);

uint16_t calculate_noise_floor(const uint16_t *samples, size_t count);

void math_engine_init_state(EncoderState *state, uint8_t encoder_id);
void math_engine_set_filter(EncoderState *state, uint8_t filter_type);
void math_engine_configure_kalman(EncoderState *state, float process_noise, float measurement_noise);
