dkontiscom/cinetracker/include/web_interface.h

#pragma once

#include <Arduino.h>
#include "math_engine.h"
#include "calibration.h"

#define WEB_SERVER_PORT 80
#define WEB_MAX_CLIENTS 4
#define WEB_REQUEST_BUFFER_SIZE 1024
// a client silent this long mid request is gone, not slow - drop it so it
// cant hold one of the few slots for good
#define WEB_CLIENT_TIMEOUT_MS 5000

struct WebContext {
  EncoderState *encoders;
  CalibrationSession *cal_session;
  CalibrationData *cal_data;
  bool *unexpected_reboot;
};

int web_interface_init();
void web_interface_process(WebContext *ctx);
bool web_is_streaming();
