dkontiscom/cinetracker/(commit log)

2026-09-22 docs
    Genlock clock servo rate limit and settling time notes from the
    source paper, plus gitignore the docs/ folder (paywalled reference
    material, must not be redistributed).
2026-10-10 tri-sync: write the trailing edge (10 -> 01) with one store
    The trailing edge of the tri-level pulse was two digitalWriteFast calls,
    bit1 LOW then bit0 HIGH. With runtime pin numbers each call is a pin table
    lookup plus a store (7 instructions between the two stores in the 25p
    build), so the output sat at 00 (-300mV) for that gap. On the v0.5c
    carrier (35 ns edges) a gap above ~2 ns pulls the trailing edge out of the
    ST 274 rise-time window at 24/25/30p, and ~10 ns adds a -3.5 mV dip.
    begin() now checks whether both pins share a GPIO port (pins 2 and 3 are
    GPIO9 bits 4 and 5) and if so the trailing edge is one store to that
    port's DR_TOGGLE register. Falls back to the two writes otherwise.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
2026-10-10 tri-sync: end the vsync broad pulse at 2112T at 24/25/50p
    ST 274:2008 10.6 / table 7: in progressive systems the broad pulse starts
    132T after 0H and lasts 1980T, ending at bp = 2112T, the same value for
    every system. The broad pulse was ended at the start of the next
    interrupt (VSYNC_END_RESET), which only lands on 2112T for 2200-sample
    lines (30/60p). At 2640-sample lines (25/50p) it ran 440T too long, at
    2750 (24p) 550T too long.
    For 24/25/50p the broad pulse is now ended inside the same interrupt
    after 1980T (16000 cycles at 24/25p, 8000 at 50p). 30/60p unchanged.
    Cost: on the 5 vsync lines per frame the priority-0 interrupt stays busy
    for ~30 us (24/25p) / ~15 us (50p). Worth a soak te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
2026-10-10 platformio: pin platform and library versions
    platform teensy@6.0.0 (core 1.162.0), QNEthernet HedgeHawk fork at
    6edbded (the ieee1588-2-fix branch head), OpenAudio at 1dbecf1 (master
    head). Before this a rebuild could silently pick up whatever those
    branches pointed to that day. Clean build from an empty .pio verified.
    Claude-Session: https://claude.ai/code/session_01XKtB9fcNwBKtm5in8woTvZ
2026-10-10 hardware: folder layout and PoE board v0.1 requirements
    hardware/README.md describes the carrier / Teensy / PoE board stack and
    the folder layout (hardware/<board>/ for KiCad and fab files,
    hardware/<board>/documentation/ for docs; not "docs" because .gitignore
    ignores every docs folder).
    hardware/poe/documentation/requirements-v0.1.md: PoE board v0.1
    requirements. M12 X-coded 8-pin socket (CAZN C7423431) so both Mode A
    and Mode B PSEs work (MikroTik is Mode B only), SDAPO DP9900LP-5V
    module, B1608S PoE magnetics, two bridges, Teensy ethernet pin and
    carrier J7 positions, isolation requirements, sources.
    Claude-Session: https://claude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
2026-10-10 hardware: carrier v0.5d as a KiCad project; fix the Teensy socket rows
    Carrier v0.3 to v0.5c placed the GND/0/1 row where the Teensy's VIN row
    lands and listed the VIN row without its GND and 3.3V pins. A Teensy
    plugged in would have had +5 V on GND and GND on VIN, with I2S, I2C and
    SPI on the wrong pins. v0.5d puts the VIN row on J8 (top) and the
    GND/0/1 row on J9 (bottom), checked against PJRC's pinout card and
    dimension drawing, and re-routes every Teensy net. Teensy position,
    orientation (USB left) and all connectors are unchanged.
    The carrier is now a KiCad 7 project:
    - hierarchical schematic (power, genlock, audio, encoders, ui),
    generated once from the routed board's netlist; edit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
    [audio.kicad_sch, carrier-v0.5d-BOM-JLCPCB.csv, carrier-v0.5d-BOM-full.csv, cinetracker-carrier.kicad_pcb, cinetracker-carrier.kicad_sch, encoders.kicad_sch, genlock.kicad_sch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]
2026-10-10 hardware: PoE board v0.1 as a KiCad project
    First design of the PoE board that sits on top of the Teensy 4.1:
    - M12 X-coded 8-pin socket (CAZN C7423431), all four pairs: Mode A via
    the B1608S cable-side centre taps, Mode B via the spare pairs, so any
    802.3af/at PSE (MikroTik included) can power it
    - SDAPO DP9900LP-5V isolated PD module, 2x MB6S bridges, SMAJ58A TVS,
    per the module's typical circuit; 100 uF + 10 uF output, 5 V LED,
    optional bleeder (DNP) for the module's 100 mA minimum load
    - Bob Smith terminations (75 ohm + 10 nF per pair, 1 nF 2 kV to the
    isolated GND) per TI SLUA454
    - Ethernet: 2x3 2.0 mm socket on the bottom onto the Teensy's Ethernet
    header (PJRC kit pin orde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
    [cinetracker-poe.kicad_pcb, cinetracker-poe.kicad_sch, poe-v0.1-BOM-JLCPCB.csv, poe-v0.1-BOM-full.csv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]
2026-10-10 hardware: carrier v0.5e with the PoE board standoff holes
    - MH5 (77.0, 48.1) and MH6 (10.0, 48.5): M2.5 NPTH holes for the PoE
    board v0.1 standoffs, in the schematic (power sheet) and on the board,
    each with a 3.2 mm copper/track/via keep-out on all four layers. Both
    spots were already free, so no copper moved. Nylon standoffs: the
    holes sit inside the PoE board's isolation band.
    - J7 unchanged: the J7 <-> PoE board link (long-pin header or cable) is
    an open decision.
    - Revision strings, fab outputs (Gerbers with the new NPTH holes, 1:1
    fit check, schematic PDF) and docs moved to v0.5e. BOM and placement
    are the same as v0.5d.
    - poe/tools/verify_poe.py also checks that MH5/MH6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
    [audio.kicad_sch, carrier-v0.5e-BOM-JLCPCB.csv, carrier-v0.5e-BOM-full.csv, cinetracker-carrier.kicad_pcb, cinetracker-carrier.kicad_sch, encoders.kicad_sch, genlock.kicad_sch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]
2026-10-10 hardware: CERN-OHL-S-2.0 licence, source location on the boards, decisions
    - hardware/LICENSE: CERN-OHL-S-2.0 (strongly reciprocal), copyright
    CineTracker contributors. Firmware stays AGPL-3.0-or-later.
    - Both boards carry the source location (github.com/dkontiscom/cinetracker)
    and licence on the bottom silkscreen, as CERN-OHL-S asks. Every
    schematic title block carries the copyright and licence line.
    Gerbers and schematic PDFs regenerated. No copper or parts moved.
    - Decisions of 2026-10-10 written into the hardware docs:
    - J3 (PoE) to J7 (carrier): long-pin 1x4 header, cut to the measured
    stack height
    - M12 shield pin 9: left open
    - M12 samples: after funding
    - carrier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
    [audio.kicad_sch, cinetracker-carrier.kicad_pcb, cinetracker-carrier.kicad_sch, cinetracker-poe.kicad_pcb, cinetracker-poe.kicad_sch, encoders.kicad_sch, genlock.kicad_sch, power.kicad_sch]
2026-10-10 docs: genlock timing notes, roadmap milestones
    - GENLOCK-TIMING.md: how the tri-level sync is made now (busy wait in a
    priority 0 interrupt), what that costs the rest of the firmware, how to
    measure it on the first boards (setup, references, load cases, what to
    record), and the planned rework onto FlexPWM4 submodule 2 (pins 2/3)
    with what it fixes and what it doesnt.
    - ARCHITECTURE.md: pins 2 and 3 now matter, they are the FlexPWM4 SM2
    A/B outputs the rework needs.
    - ROADMAP.md: the existing numbered list kept as written, milestones
    M1-M7 added (repo ready, extended FreeD sender, LiveLink plugin,
    hardware prototypes, hardware timer genlock, field tests, web ui
    firmware update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
2026-10-10 docs: extended FreeD spec draft, new top level readme
    - EXTENDED-FREED.md, draft 0.1: separate 52 byte packet next to plain
    D1 (never appended to it), plain / extended / both switch with both as
    default, fields: D1 data, 24 bit iris, sequence number, flags, PTP
    sample time (IEEE 1588 format), SMPTE timecode. Open questions listed.
    - README.md: what it is, how the parts fit together, repo layout,
    hardware status, building, licence split (firmware AGPL, hardware
    CERN-OHL-S), spec licence marked open.
    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
2026-10-10 hardware docs: changelog entries for the licence and decisions
    - carrier and PoE changelogs: same-revision update entries (silkscreen
    source location, title blocks, decisions of 2026-10-10)
    - PoE design notes: J3 options text no longer says the choice is open
    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
2026-10-10 hardware: carrier v0.60 - 0.1 % genlock resistors, MISO pull-ups, connector courtyards
    - R1, R2, R4 (2k), R3 (1k), R5 (5.1k), R15 (5.6k): 0.1 % thin film
    (YAGEO RT0805B C706274 / C110774 / C122968, Panasonic ERA6AEB562V
    C445654). Same 0805 footprints and values; the value text shows 0.1 %.
    Monte Carlo: 100 % of boards inside +-6 mV (73-97 % with 1 %).
    - R27, R28: 10k pull-ups to +3V3 on SPI_MISO and SPI1_MISO, so an
    unplugged focus or zoom encoder reads 0xFFFF (error flag set) and the
    power-up detection reports it as not connected. Placed at (28.5, 19.25)
    and (6.75, 36.0); three vias and five short tracks, nothing else moved.
    - BNC and M8 footprints (board and lib/) get courtyard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
    [audio.kicad_sch, carrier-v0.5e-BOM-full.csv, carrier-v0.60-BOM-JLCPCB.csv, carrier-v0.60-BOM-full.csv, cinetracker-carrier.kicad_pcb, cinetracker-carrier.kicad_sch, encoders.kicad_sch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]
2026-10-10 hardware: PoE board renumbered v0.1 -> v0.60, docs follow both boards
    - PoE board: same circuit, layout and BOM as v0.1, now called v0.60 so
    both boards carry one revision. Silkscreen and title block updated;
    fab files, schematic PDF, renders and the stack fit check regenerated
    (the fit check now shows the carrier v0.60 connector courtyards).
    - PoE open issues: the M12 sample check now also covers the shell
    material (datasheet lists brass / zinc / PA+GF without saying which)
    and the unpublished contact-to-shell withstand voltage, which matters
    with a metal panel and GND = chassis.
    - hardware/README.md, README.md, ROADMAP.md: v0.60 status; before any
    order: owner review, then a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
    [cinetracker-poe.kicad_pcb, cinetracker-poe.kicad_sch, poe-v0.1-BOM-full.csv, poe-v0.60-BOM-JLCPCB.csv, poe-v0.60-BOM-full.csv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]
2026-10-11 hardware: both boards moved to KiCad 10.0.7, first ERC, fab files regenerated
    - schematics, boards and project libraries upgraded from KiCad 7.0.11 to KiCad 10
    - first ERC (KiCad 7's cli had none): carrier 5 errors / 3 warnings, PoE 1 warning,
    all fixed, no wiring faults (duplicate Teensy 3V3 power_out pin, PWR_FLAGs on
    +5V / GND / +3V3A / +5VA, two symbol caches refreshed from the KiCad 10 library)
    - boards updated from schematic and from the KiCad 10 libraries: library graphics
    and 3D models, symbol fields on footprints, unconnected-... nets on no-connect
    pads, PoE root-sheet nets renamed to /NAME with the Primary net class patterns
    and the isolation rule following; zones refille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
    [audio.kicad_sch, cinetracker-carrier.kicad_pcb, cinetracker-carrier.kicad_sch, cinetracker-poe.kicad_pcb, cinetracker-poe.kicad_sch, encoders.kicad_sch, genlock.kicad_sch, power.kicad_sch]
2026-10-11 hardware: v0.61 for both boards, PoE track off the M12 housing pin, encoder cable guide
    - PoE: MDI_TX_P ran from J1 pin 1 through the middle of the M12 pin circle, 0.45 mm
    from pin 9 (housing contact, on the chassis once mounted). Now routed round the
    outside; MDI_RX_N moved to B.Cu next to MDI_RX_P with one via by T1.16
    - new DRC rule "M12 housing contact": >= 1.53 mm from pin 9 (the connector's own pin
    spacing). nearest track now 1.79 mm; the rule flags the old route, so it is active.
    verify_poe.py reports it (4b)
    - both boards renumbered v0.61 (KiCad 10 move + the PoE fix): silkscreen, title
    blocks, fab file names, schematic PDFs, renders. BOM and CPL unchanged
    - carrier/documen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
    [audio.kicad_sch, carrier-v0.61-BOM-JLCPCB.csv, carrier-v0.61-BOM-full.csv, cinetracker-carrier.kicad_pcb, cinetracker-carrier.kicad_sch, cinetracker-poe.kicad_pcb, cinetracker-poe.kicad_sch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]
2026-10-11 firmware: read the encoders right before each FreeD packet is built
    - network_process_frame split into network_frame_due() and network_send_frame(), so
    loop() can call encoder_refresh_now() between "a frame is due" and building it
    - encoder_refresh_now(): iris over i2c first, then focus and zoom over spi, through
    the same accumulate() unwrap as the 1 kHz timer samples; focus/zoom come out of the
    isr mask while read. data age at build goes from up to 1 ms (timer sample) to a
    couple of hundred us at most (estimated, not measured)
    - the filter still runs once per loop pass
    - fix: actual_fps was computed from the send time just stored, which wrapped
    negative, so the ui showed ~0 fps wh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
    [encoder_driver.cpp, encoder_driver.h, main.cpp, network_stack.cpp, network_stack.h]
2026-10-11 firmware: AS5048 SPI chip-select timing down to the datasheet values
    as5048_transfer waited 10 us after CS low and 10 us after CS high. DS000298 v1-11
    (SPI timing table) asks for 350 ns CS low to first CLK, 50 ns last CLK to CS high,
    350 ns CS high between frames. now 500 / 100 / 500 ns with delayNanoseconds.
    a register read (two frames) goes from ~44 us to ~6-7 us at 8 MHz, the 1 kHz
    sampling isr from ~88 us to ~14 us per ms, and read-before-send reads focus/zoom
    ~15 us before the packet is built. estimated from the code, not measured.
    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
