dkontiscom/cinetracker/(notices)

Notices in the files:
hardware/carrier/cinetracker-carrier.kicad_pcb:
github.com/dkontiscom/cinetracker CERN-OHL-S-2.0
